ALT2-ASH/HW_RV1103_ESP32_Controller_Gateway/production/BOM_JLCPCB.csv

Comment | Designator | Footprint | JLCPCB Part #
CR2032 | BT1 | BatteryHolder_MYOUNG_BS-05_CR2032_Vertical_Overhang | C2902326
100nF / 100nF 50V | C1,C75,C201,C202,C203,C204,C205,C206,C207,C208,C209,C210 | C_0603_1608Metric | C14663
100nF | C2 | C_0805_2012Metric | C28233
33uF | C3 | CP_Elec_6.3x7.7 | C402500
2.2uF | C4,C5 | C_1210_3225Metric | C42400139
47uF | C6,C7,C8 | C_1206_3216Metric | C96123
47pF | C9 | C_0402_1005Metric | C1567
6.8nF | C10 | C_0402_1005Metric | C1542
22pF | C11 | C_0402_1005Metric | C1555
22uF | C12,C17,C18,C20,C71 | C_0603_1608Metric | C59461
10uF | C13,C21,C22,C24,C30,C31,C35,C36,C44,C55,C56 | C_0603_1608Metric | C19702
2.2uF | C14 | C_0603_1608Metric | C23630
100nF | C15,C23,C26,C27,C28,C29,C37,C38,C39,C40,C41,C42,C45,C46,C47,C48,C49,C50,C51,C53,C54,C60,C62,C63,C68,C70,C72,C73,C74,C76,C77,C78,C79 | C_0402_1005Metric | C1525
6.8pF | C16,C19 | C_0402_1005Metric | C1576
1uF | C25,C32,C33,C34,C52,C61,C67,C69 | C_0402_1005Metric | C52923
1nF | C43 | C_0402_1005Metric | C1523
18pF | C57,C58 | C_0402_1005Metric | C1549
4.7uF | C59 | C_0603_1608Metric | C19666
10nF | C64,C65 | C_0402_1005Metric | C15195
1nF 2kV | C66 | C_1206_3216Metric | C9196
SS510 | D1 | D_SMA | C65010
SMBJ33A | D2 | D_SMB | C78419
SS54 | D3 | D_SMA | C22452
SS56B | D4 | D_SMB | C18199180
SMF5.0A | D5,D6,D7,D18,D19,D20 | D_SOD-123F | C2759874
PSM712 | D8 | SOT-23 | C32677
SMF12A | D9 | D_SOD-123F | C19077506
1N4148W | D10,D11,D12,D13,D14,D15,D16,D17 | D_SOD-123 | C81598
LED | D201,D202,D203,D204,D205,D206,D207,D208 | LED_D3.0mm | C99771
BAT54C | D209 | SOT-23 | C37704
PTC 2.5A 48V | F1 | Fuse_2920_7451Metric | C49326264
BLM15PD121SN1D | FB1,FB2,FB3 | L_0402_1005Metric | C76891
DC 12-24V | J1 | DC-005-A200_XUNPU_Horizontal | C720557
USB_C_Receptacle_USB2.0_16P | J2 | USB_C_Receptacle_HRO_TYPE-C-31-D-06_Vertical | C22464422
FRONT_BTN / FRONT_LED | J4,J5 | PinHeader_1x02_P2.54mm_Vertical | C492401
HY911105AE | J6 | RJ45_Hanrun_HY911105AE_Horizontal | C69427
RS485 / I2C | J7,J10 | TerminalBlock_DB127V-5.0_1x04_P5.00mm | C430624
DIM 0-10V / IN1 | J9,J15 | TerminalBlock_DB127V-5.0_1x02_P5.00mm | C395885
PANEL CH1-4 / PANEL CH5-8 | J11,J12 | PinHeader_2x04_P2.54mm_Vertical | C492421
PANEL IN/PWR POST | J13 | PinHeader_1x06_P2.54mm_Vertical | C492405
IN2-3 | J14 | TerminalBlock_DB127V-5.0_1x03_P5.00mm | C395886
RELAY 1-4 / RELAY 5-8 | J16,J17 | TerminalBlock_bornier-8_P5.08mm | C5143711
G5Q-1A4 DC5 | K1,K2,K3,K4,K5,K6,K7,K8 | Relay_SPST_Omron-G5Q-1A | C5204063
8.2uH | L1 | L_Sunlord_SWPA8065S | C168161
2.2uH | L2,L3,L4 | L_Sunlord_SWPA4030S | C279948
RED | LED0,LED1 | LED_0603_1608Metric | C2286
AO3401A | Q1 | SOT-23 | C15127
AO3400A | Q2,Q3,Q4,Q5,Q6,Q7,Q8,Q9,Q10 | SOT-23 | C20917
470k | R1 | R_0402_1005Metric | C25790
150k | R2,R8 | R_0402_1005Metric | C25755
100k | R3,R16,R17,R18,R22,R23 | R_0402_1005Metric | C25741
18k | R4 | R_0402_1005Metric | C25762
75k | R5 | R_0402_1005Metric | C25798
12k | R6 | R_0402_1005Metric | C25752
10k | R7,R15,R21,R26,R41,R42,R46,R47,R48,R49,R50,R51,R52,R54,R60,R61,R66 | R_0402_1005Metric | C25744
200k | R9,R14 | R_0402_1005Metric | C25764
5.1k | R10,R11 | R_0402_1005Metric | C25905
33k | R12 | R_0402_1005Metric | C25779
51k | R13 | R_0402_1005Metric | C25794
4.7k | R19,R40,R83,R84,R87,R89,R90 | R_0402_1005Metric | C25900
100R | R20,R25,R33,R36,R63,R64,R65,R67,R68,R69,R70,R75,R76,R77,R78 | R_0402_1005Metric | C25076
330R | R24 | R_0402_1005Metric | C25104
1M | R27,R39 | R_0402_1005Metric | C26083
22R | R28,R43 | R_0402_1005Metric | C25092
1R | R29 | R_0402_1005Metric | C25086
240R | R30 | R_0402_1005Metric | C114755
6.04k | R31 | R_0402_1005Metric | C97819
0R | R32,R34,R35,R37 | R_0402_1005Metric | C17168
1k | R38,R85,R86,R88,R91 | R_0402_1005Metric | C11702
2.2k | R44,R45,R71,R72,R73,R74,R79,R80,R81,R82 | R_0402_1005Metric | C25879
390R | R53,R59 | R_0603_1608Metric | C23151
10R | R55,R58 | R_0805_2012Metric | C17415
33R | R56 | R_0402_1005Metric | C25105
120R | R57 | R_0603_1608Metric | C22787
22k | R62 | R_0402_1005Metric | C25768
0.47R | R92 | R_1206_3216Metric | C327076
2.2k | R201,R202,R203,R204,R205,R206,R207,R208 | R_0603_1608Metric | C4190
RECOVERY | SW1 | SW_SPST_TL3342 | C318884
SW_Push | SW201,SW202,SW203,SW204,SW205,SW206,SW207,SW208 | SW_PUSH_6mm_H8mm | C2845266
TPS54360BDDAR | U1 | TI_SO-PowerPAD-8_ThermalVias | C524806
TLV62569DBVR | U2,U4,U5 | SOT-23-5_TI_DBV0005A | C141836
USBLC6-2SC6 | U3,U10 | SOT-23-6 | C7519
RV1103G1 | U6 | QFN-88-1EP_9x9mm_P0.35mm_EP6.5x6.5mm | C5307358
W25N01KVZEIR | U7 | WSON-8-1EP_8x6mm_P1.27mm_EP3.4x4.3mm_HandSolder | C22472329
ESP32-C6-MINI-1U-H4 | U8 | ESP32-C6-MINI-1U | C20627095
SP3485EN-L/TR | U9 | SOIC-8_3.9x4.9mm_P1.27mm | C8963
LM321A | U11 | SOT-23-5 | C2842352
DAC5571 | U12 | SOT-23-6 | C24061
PCA9555PW | U201 | TSSOP-24_4.4x7.8mm_P0.65mm | C128392
RX8900CE | U202 | EPSON_CE-USON-10_USON-10_3.2x2.5mm_P0.7mm | C54946598
24MHz | Y1 | Crystal_SMD_2016-4Pin_2.0x1.6mm | C5261099
LED spacer 4x10mm | SP201,SP202,SP203,SP204,SP205,SP206,SP207,SP208 | LED_Spacer_4x10mm | C94096
