ALT2-ASH/HW_RV1103_ESP32_Controller_Gateway/rv1103_esp32.kicad_pcb

## KiCad design rv1103_esp32.kicad_pcb (2026-11-07)

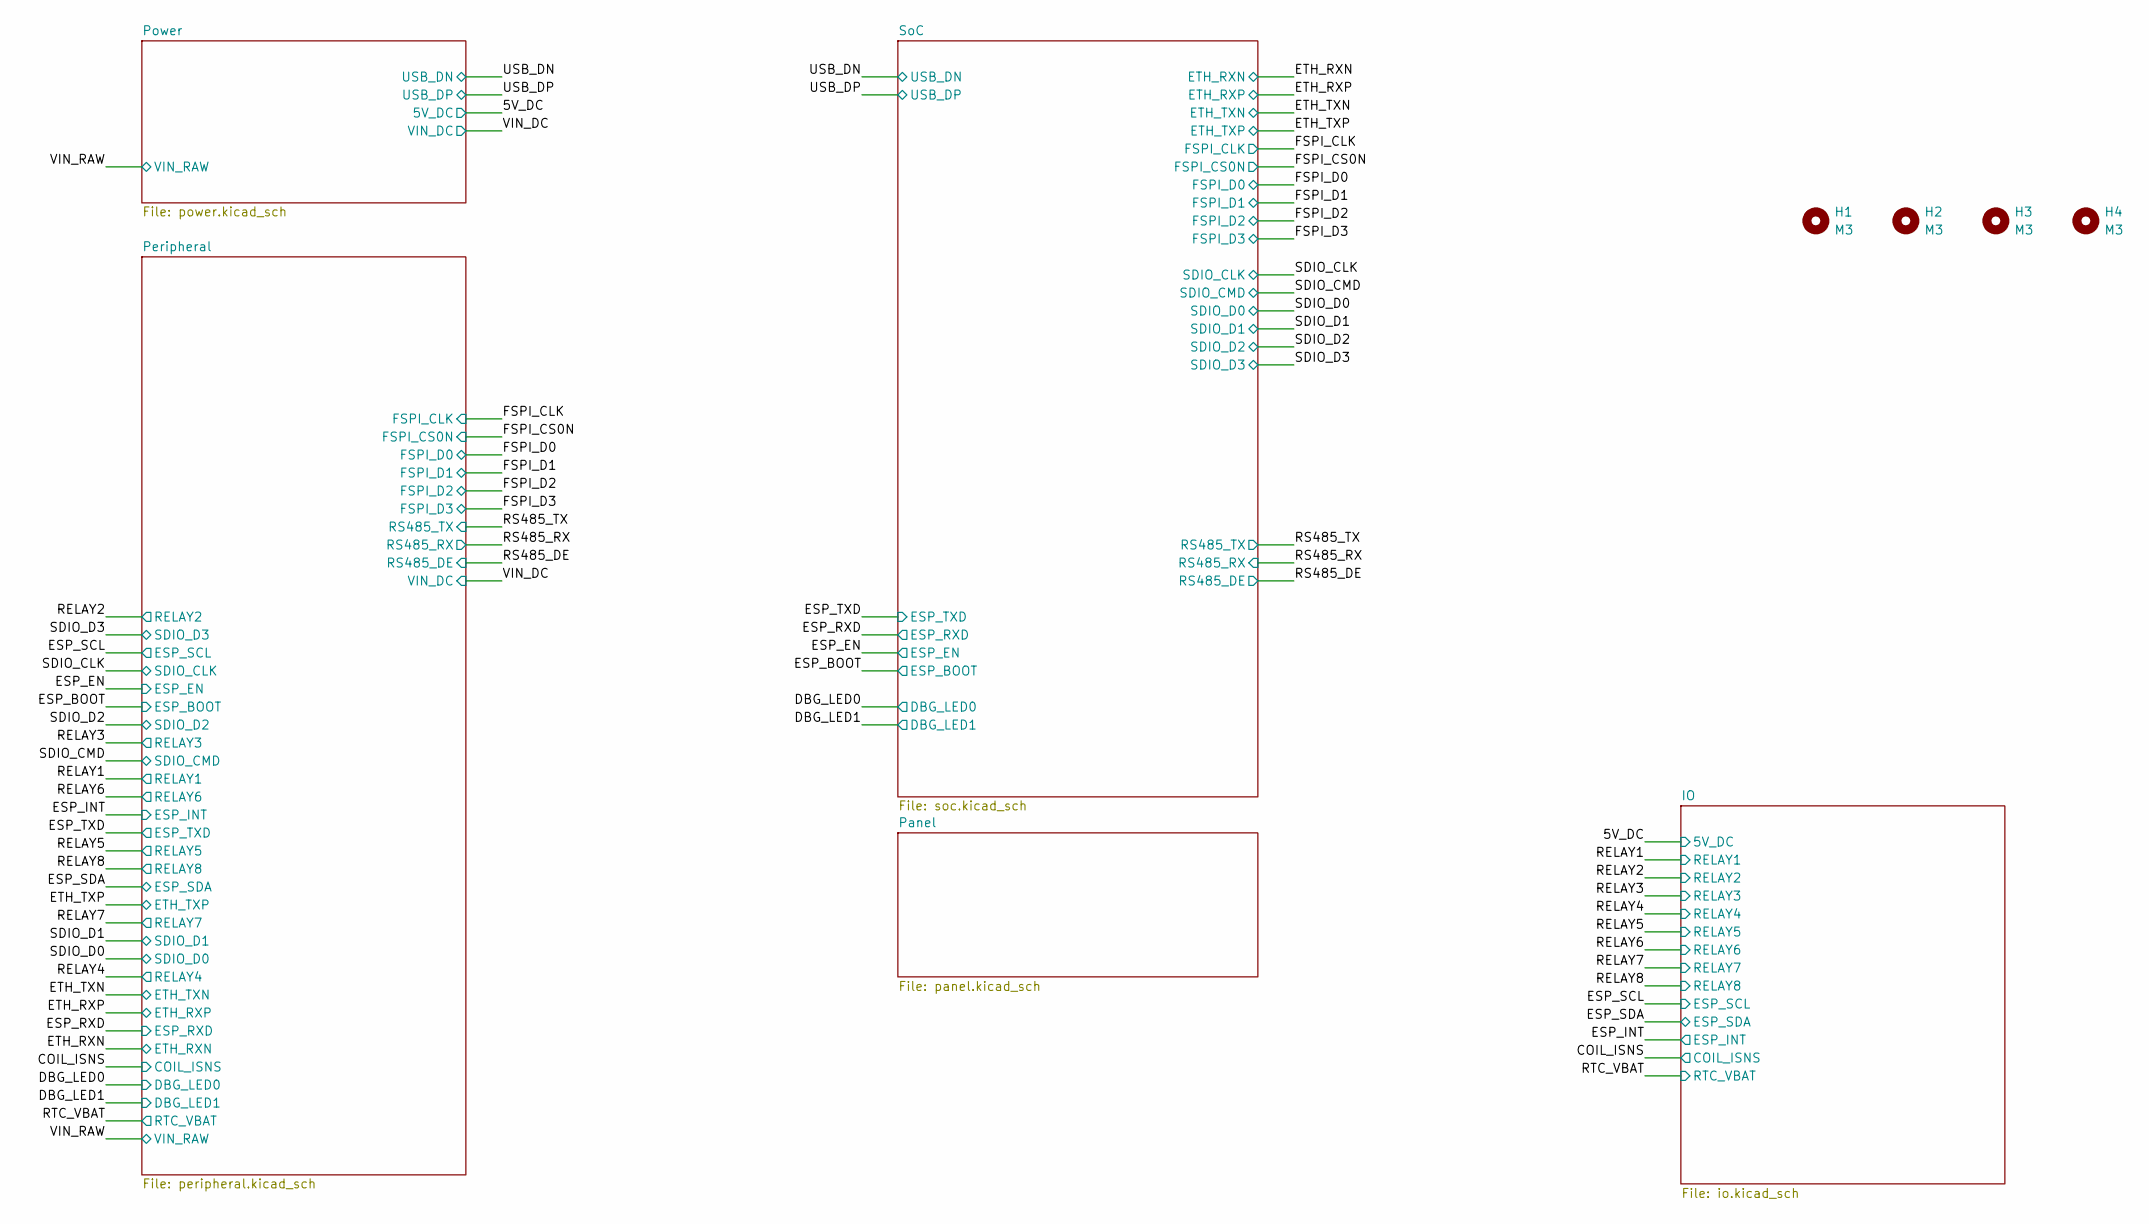
[picture p1: schematic rv1103_esp32.kicad_sch]

Parts:
H1, H2, H3, H4: M3; MountingHole_3.2mm_M3

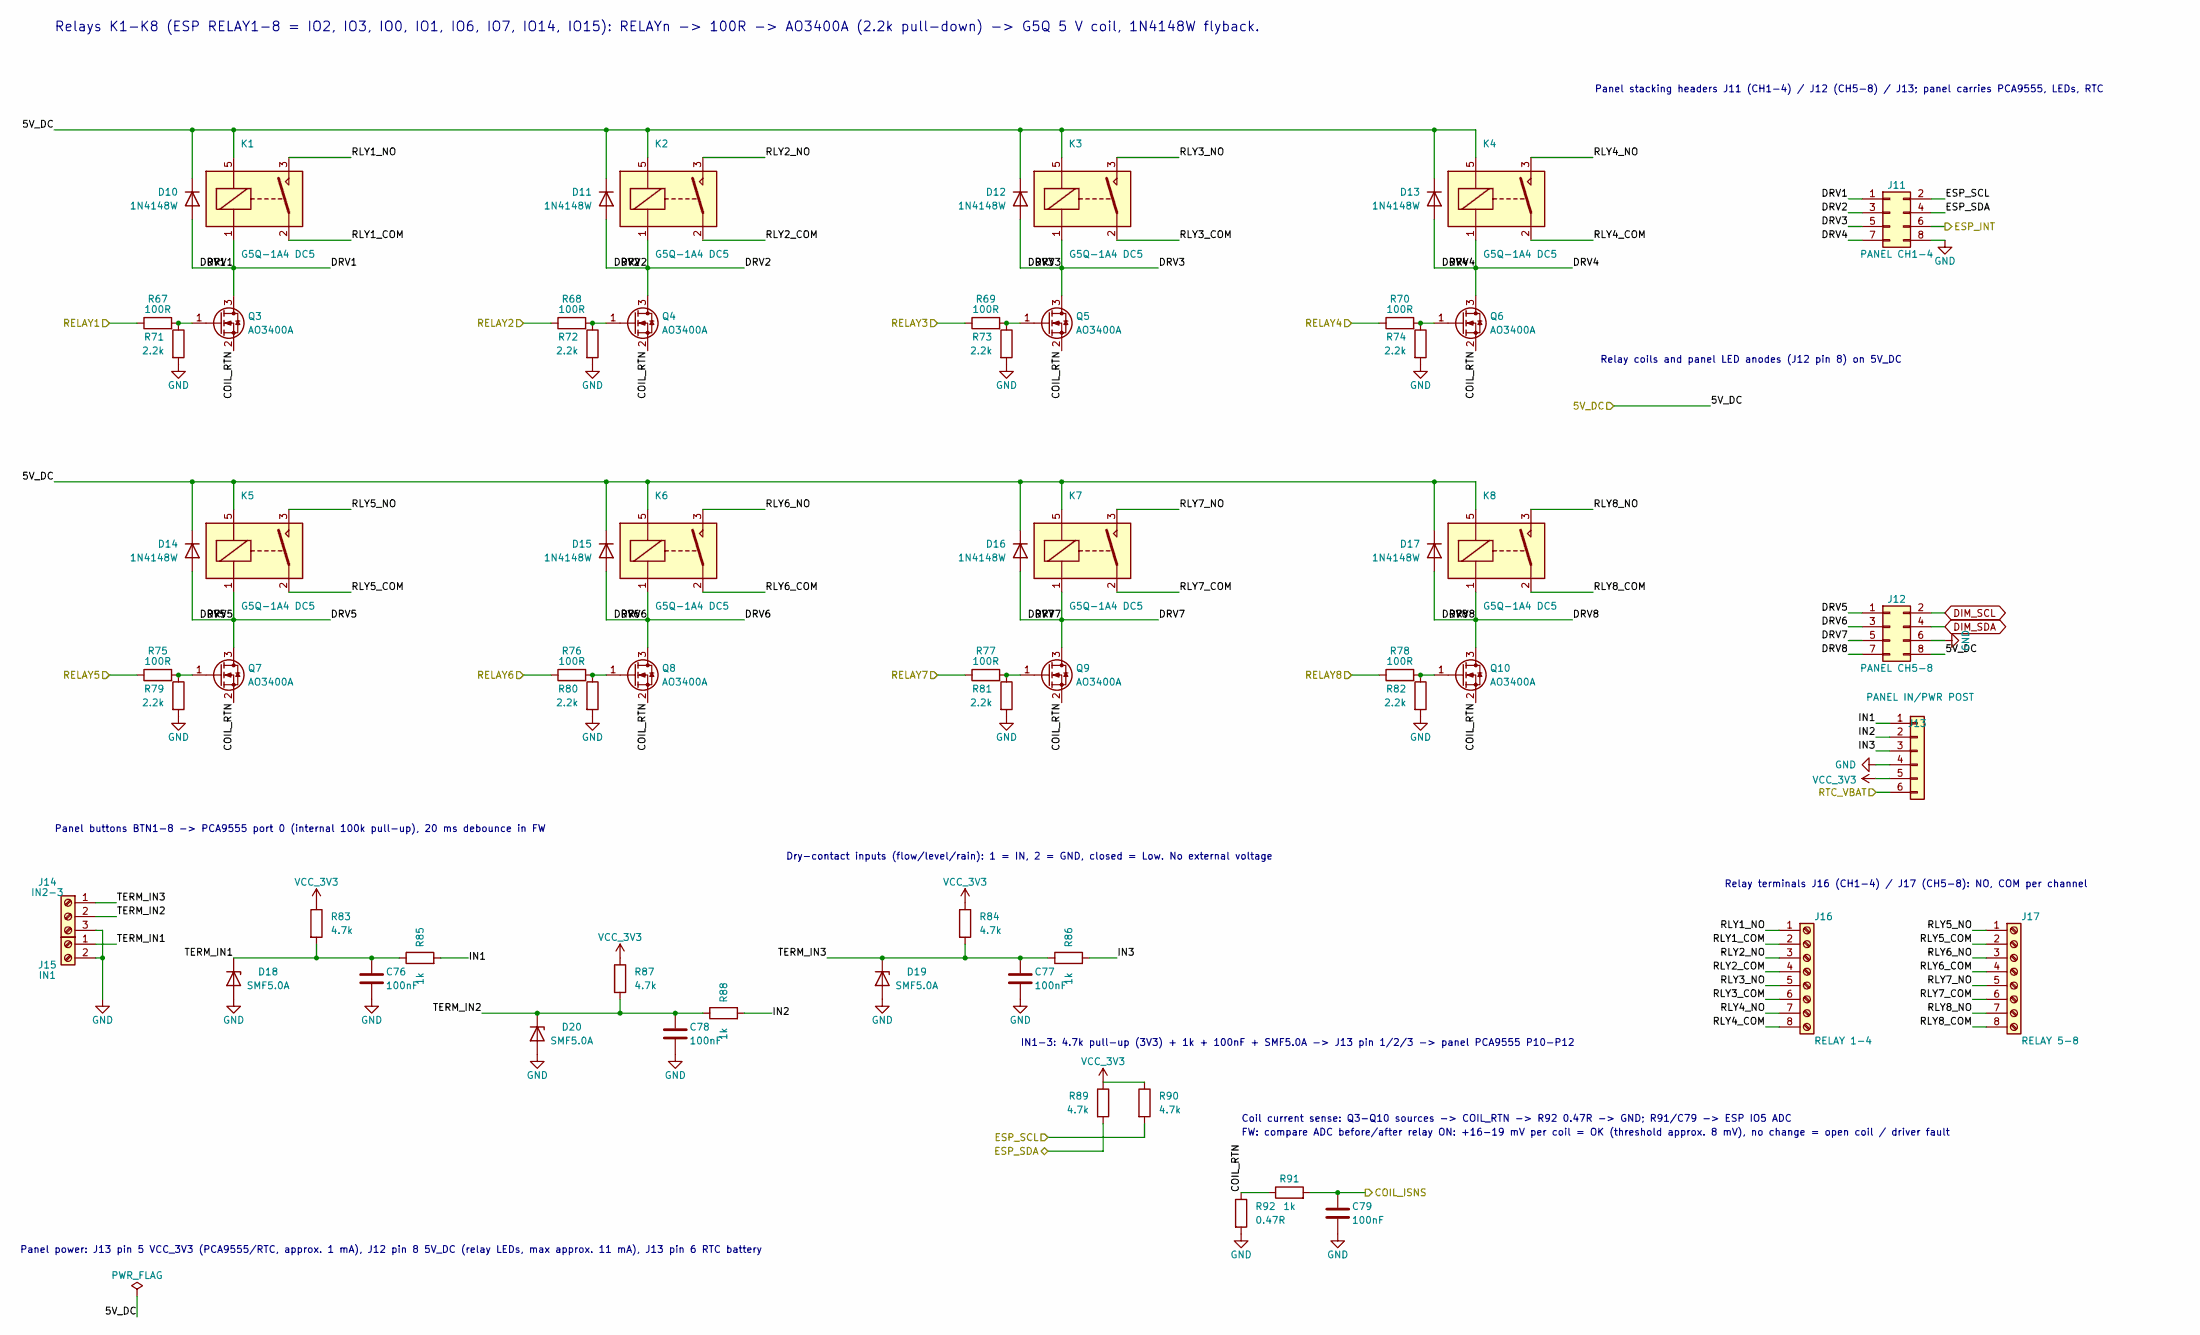
[picture p2: schematic io.kicad_sch]

Parts:
C76, C77, C78, C79: 100nF; C_0402_1005Metric; LCSC C1525
D10, D11, D12, D13, D14, D15, D16, D17: 1N4148W; D_SOD-123; MPN 1N4148W; LCSC C81598
D18, D19, D20: SMF5.0A; D_SOD-123F; LCSC C2759874
J11: PANEL CH1-4; PinHeader_2x04_P2.54mm_Vertical; MPN PZ254V-12-8P; LCSC C492421
J12: PANEL CH5-8; PinHeader_2x04_P2.54mm_Vertical; MPN PZ254V-12-8P; LCSC C492421
J13: PANEL IN/PWR POST; PinHeader_1x06_P2.54mm_Vertical; LCSC C492405
J14: IN2-3; TerminalBlock_DB127V-5.0_1x03_P5.00mm; MPN DB127V-5.0-3P-GN-S; LCSC C395886
J15: IN1; TerminalBlock_DB127V-5.0_1x02_P5.00mm; MPN DB127V-5.0-2P-GN-S; LCSC C395885
J16: RELAY 1-4; TerminalBlock_bornier-8_P5.08mm; MPN DB128V-5.08-8P-GN-S; LCSC C5143711
J17: RELAY 5-8; TerminalBlock_bornier-8_P5.08mm; MPN DB128V-5.08-8P-GN-S; LCSC C5143711
K1, K2, K3, K4, K5, K6, K7, K8: G5Q-1A4 DC5; Relay_SPST_Omron-G5Q-1A; MPN G5Q-1A4 DC5; LCSC_ALT C397241 G5Q-14 DC5 (SPDT 400mW coil, pa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
Q3, Q4, Q5, Q6, Q7, Q8, Q9, Q10: AO3400A; SOT-23; MPN AO3400A; LCSC C20917
R67, R68, R69, R70, R75, R76, R77, R78: 100R; R_0402_1005Metric; LCSC C25076
R71, R72, R73, R74, R79, R80, R81, R82: 2.2k; R_0402_1005Metric; LCSC C25879
R83, R84, R87, R89, R90: 4.7k; R_0402_1005Metric; LCSC C25900
R85, R86, R88, R91: 1k; R_0402_1005Metric; LCSC C11702
R92: 0.47R; R_1206_3216Metric; LCSC C327076

Connections:
/5V_DC: D10.1 (K), D11.1 (K), D12.1 (K), D13.1 (K), D14.1 (K), D15.1 (K), D16.1 (K), D17.1 (K), J12.8, K1.5, K2.5, K3.5, K4.5, K5.5, K6.5, K7.5, K8.5; also elsewhere on the board
/COIL_ISNS: C79.1, R91.2; also elsewhere on the board
/ESP_INT: J11.6; also elsewhere on the board
/ESP_SCL: J11.2, R90.2; also elsewhere on the board
/ESP_SDA: J11.4, R89.2; also elsewhere on the board
/IO/COIL_RTN: Q3.2 (S), Q4.2 (S), Q5.2 (S), Q6.2 (S), Q7.2 (S), Q8.2 (S), Q9.2 (S), Q10.2 (S), R91.1, R92.1
/IO/DRV1: D10.2 (A), J11.1, K1.1, Q3.3 (D)
/IO/DRV2: D11.2 (A), J11.3, K2.1, Q4.3 (D)
/IO/DRV3: D12.2 (A), J11.5, K3.1, Q5.3 (D)
/IO/DRV4: D13.2 (A), J11.7, K4.1, Q6.3 (D)
/IO/DRV5: D14.2 (A), J12.1, K5.1, Q7.3 (D)
/IO/DRV6: D15.2 (A), J12.3, K6.1, Q8.3 (D)
/IO/DRV7: D16.2 (A), J12.5, K7.1, Q9.3 (D)
/IO/DRV8: D17.2 (A), J12.7, K8.1, Q10.3 (D)
/IO/IN1: J13.1, R85.2
/IO/IN2: J13.2, R88.2
/IO/IN3: J13.3, R86.2
/IO/RLY1_COM: J16.2, K1.2
/IO/RLY1_NO: J16.1, K1.3
/IO/RLY2_COM: J16.4, K2.2
/IO/RLY2_NO: J16.3, K2.3
/IO/RLY3_COM: J16.6, K3.2
/IO/RLY3_NO: J16.5, K3.3
/IO/RLY4_COM: J16.8, K4.2
/IO/RLY4_NO: J16.7, K4.3
/IO/RLY5_COM: J17.2, K5.2
/IO/RLY5_NO: J17.1, K5.3
/IO/RLY6_COM: J17.4, K6.2
/IO/RLY6_NO: J17.3, K6.3
/IO/RLY7_COM: J17.6, K7.2
/IO/RLY7_NO: J17.5, K7.3
/IO/RLY8_COM: J17.8, K8.2
/IO/RLY8_NO: J17.7, K8.3
/IO/TERM_IN1: C76.1, D18.1 (K), J15.1, R83.2, R85.1
/IO/TERM_IN2: C78.1, D20.1 (K), J14.2, R87.2, R88.1
/IO/TERM_IN3: C77.1, D19.1 (K), J14.1, R84.2, R86.1
/RELAY1: R67.1; also elsewhere on the board
/RELAY2: R68.1; also elsewhere on the board
/RELAY3: R69.1; also elsewhere on the board
/RELAY4: R70.1; also elsewhere on the board
/RELAY5: R75.1; also elsewhere on the board
/RELAY6: R76.1; also elsewhere on the board
/RELAY7: R77.1; also elsewhere on the board
/RELAY8: R78.1; also elsewhere on the board
/RTC_VBAT: J13.6; also elsewhere on the board
DIM_SCL: J12.2; also elsewhere on the board
DIM_SDA: J12.4; also elsewhere on the board
GND: C76.2, C77.2, C78.2, C79.2, D18.2 (A), D19.2 (A), D20.2 (A), J11.8, J12.6, J13.4, J14.3, J15.2, R71.2, R72.2, R73.2, R74.2, R79.2, R80.2, R81.2, R82.2, R92.2; also elsewhere on the board
unnamed: Q3.1 (G), R67.2, R71.1
unnamed: Q4.1 (G), R68.2, R72.1
unnamed: Q5.1 (G), R69.2, R73.1
unnamed: Q6.1 (G), R70.2, R74.1
unnamed: Q7.1 (G), R75.2, R79.1
unnamed: Q8.1 (G), R76.2, R80.1
unnamed: Q9.1 (G), R77.2, R81.1
unnamed: Q10.1 (G), R78.2, R82.1
VCC_3V3: J13.5, R83.1, R84.1, R87.1, R89.1, R90.1; also elsewhere on the board

Notes on the sheet:
FW: compare ADC before/after relay ON: +16-19 mV per coil = OK (threshold approx. 8 mV), no change = open coil / driver fault
Relay coils and panel LED anodes (J12 pin 8) on 5V_DC
Panel stacking headers J11 (CH1-4) / J12 (CH5-8) / J13; panel carries PCA9555, LEDs, RTC
IN1-3: 4.7k pull-up (3V3) + 1k + 100nF + SMF5.0A -> J13 pin 1/2/3 -> panel PCA9555 P10-P12
Relay terminals J16 (CH1-4) / J17 (CH5-8): NO, COM per channel
Panel power: J13 pin 5 VCC_3V3 (PCA9555/RTC, approx. 1 mA), J12 pin 8 5V_DC (relay LEDs, max approx. 11 mA), J13 pin 6 RTC battery
Coil current sense: Q3-Q10 sources -> COIL_RTN -> R92 0.47R -> GND; R91/C79 -> ESP IO5 ADC
Relays K1-K8 (ESP RELAY1-8 = IO2, IO3, IO0, IO1, IO6, IO7, IO14, IO15): RELAYn -> 100R -> AO3400A (2.2k pull-down) -> G5Q 5 V coil, 1N4148W flyback.
Panel buttons BTN1-8 -> PCA9555 port 0 (internal 100k pull-up), 20 ms debounce in FW
Dry-contact inputs (flow/level/rain): 1 = IN, 2 = GND, closed = Low. No external voltage

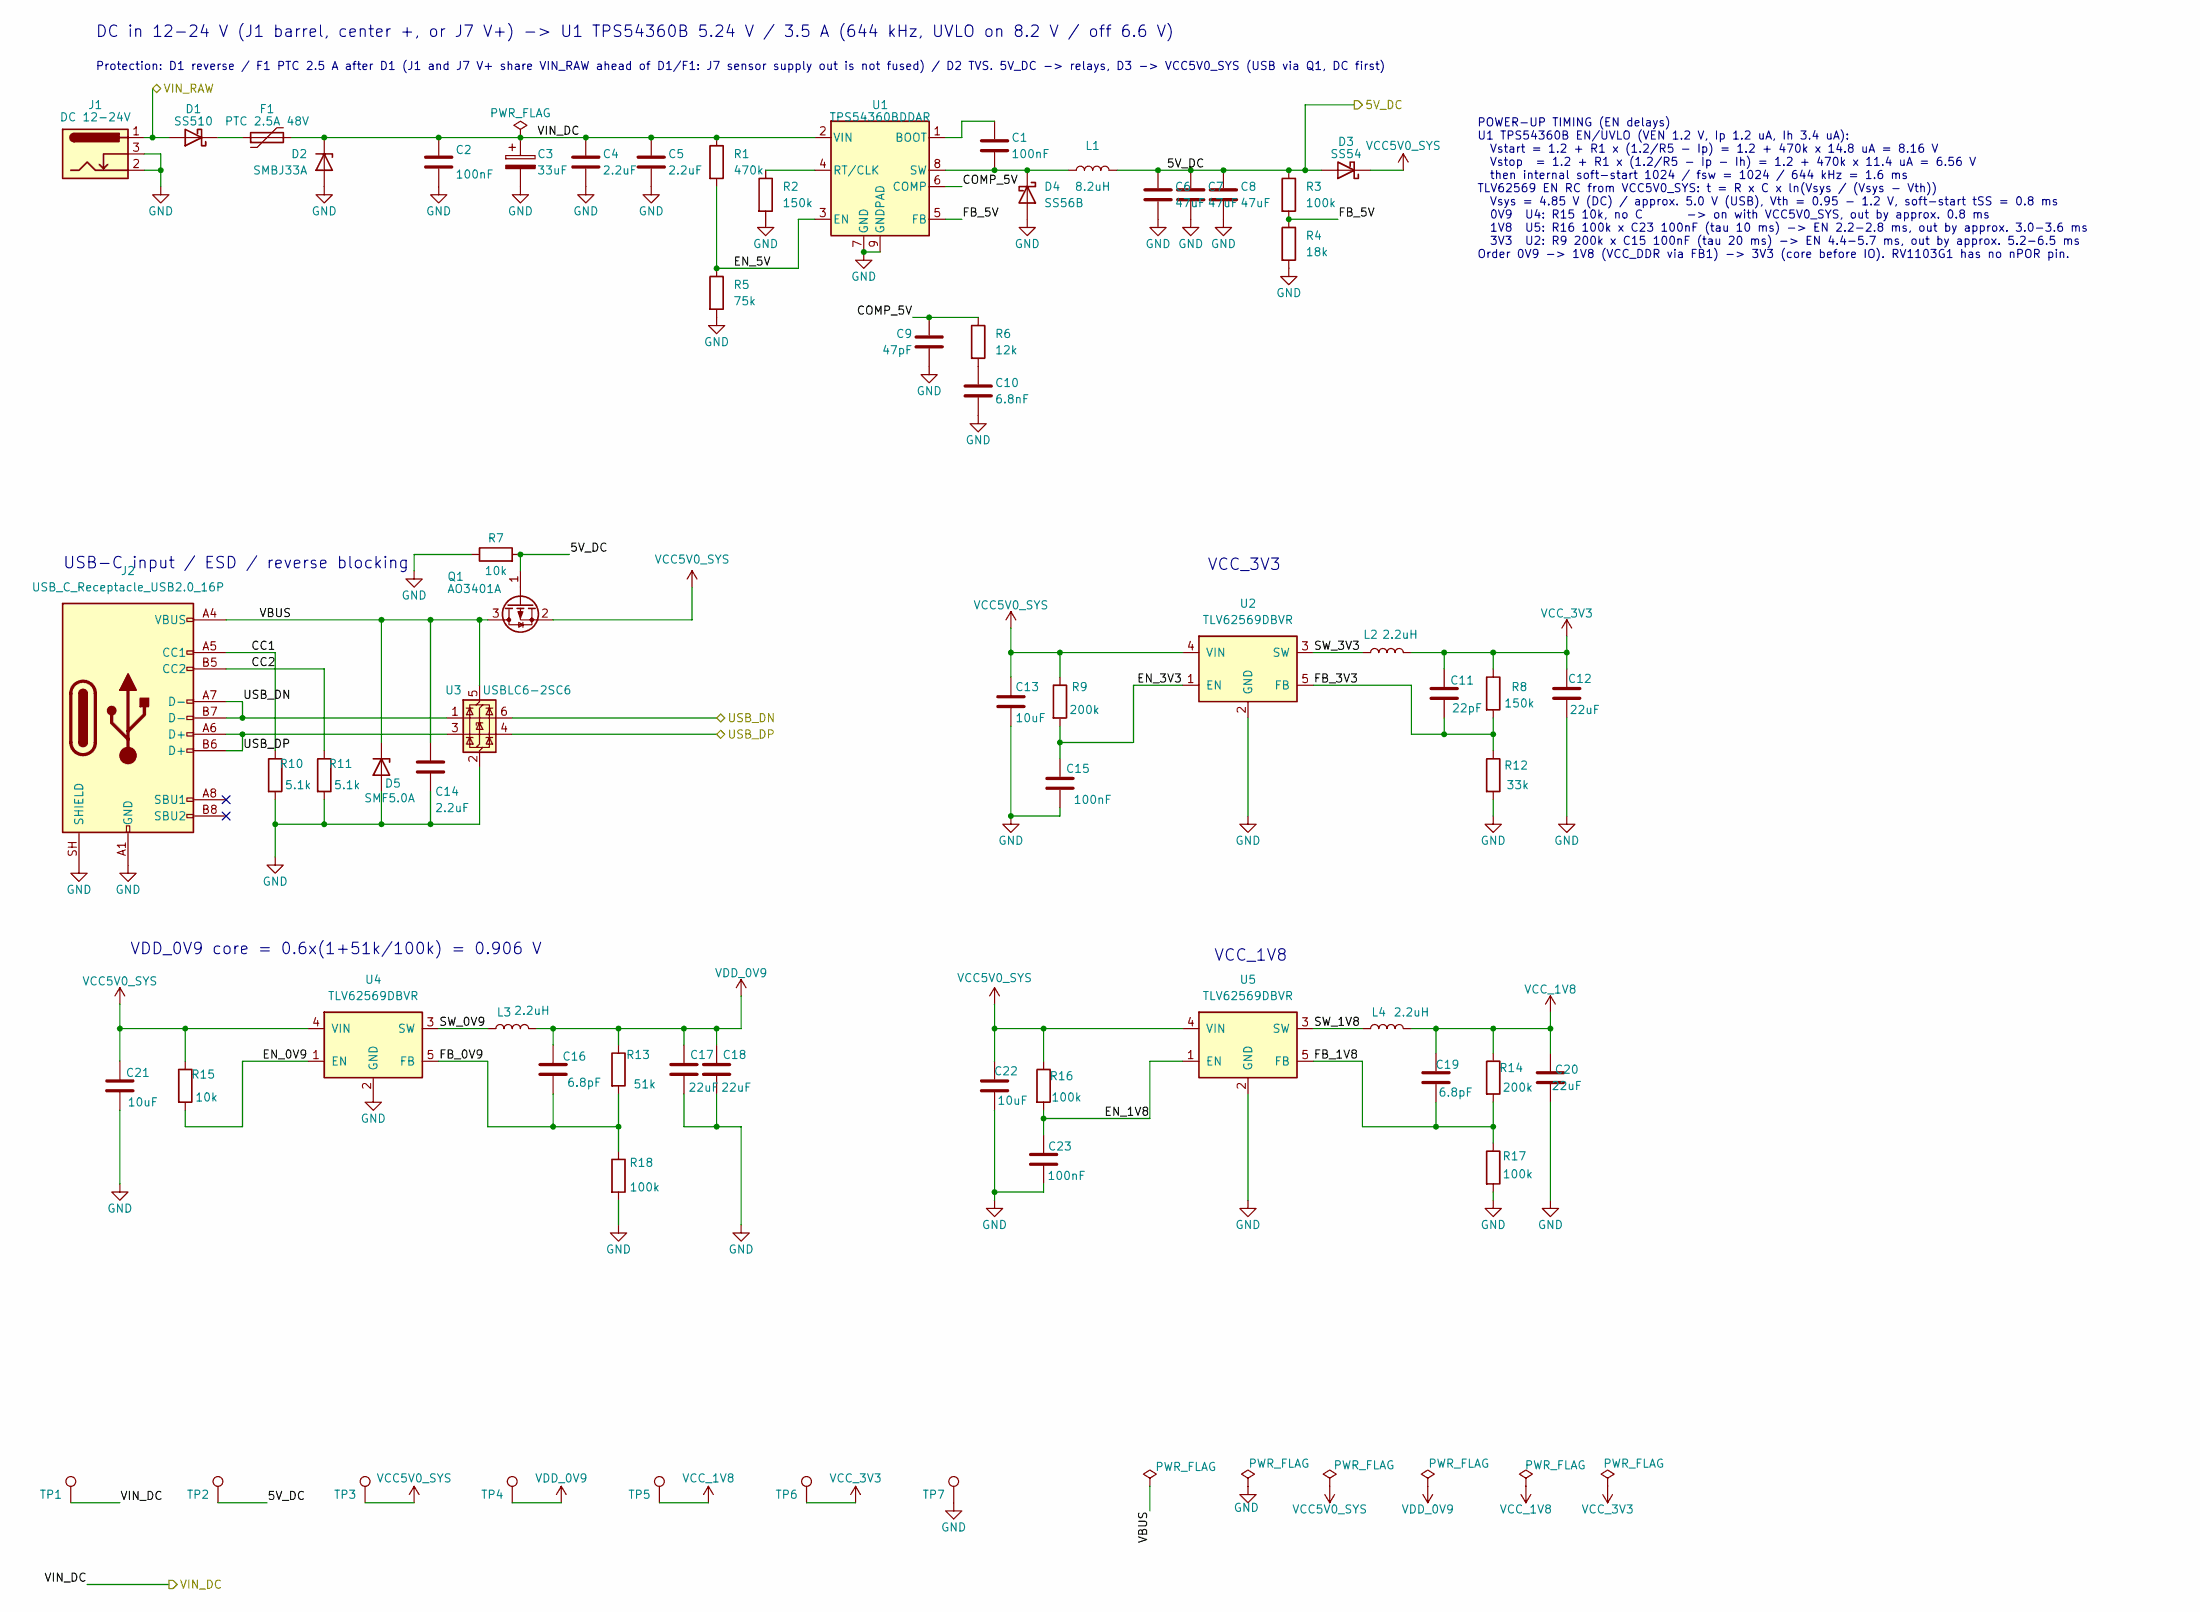
[picture p3: schematic power.kicad_sch]

Parts:
C1: 100nF; C_0603_1608Metric; LCSC C14663
C2: 100nF; C_0805_2012Metric; LCSC C28233
C3: 33uF; CP_Elec_6.3x7.7; Voltage 63V; MPN MV330M063E077ETR; LCSC C402500
C4, C5: 2.2uF; C_1210_3225Metric; Voltage 100V; MPN 1210B225K101NT; LCSC C42400139
C6, C7, C8: 47uF; C_1206_3216Metric; Voltage 10V; MPN CL31A476MPHNNNE; LCSC C96123
C9: 47pF; C_0402_1005Metric; MPN 0402CG470J500NT; LCSC C1567
C10: 6.8nF; C_0402_1005Metric; LCSC C1542
C11: 22pF; C_0402_1005Metric; MPN 0402CG220J500NT; LCSC C1555
C12, C17, C18, C20: 22uF; C_0603_1608Metric; LCSC C59461
C13, C21, C22: 10uF; C_0603_1608Metric; LCSC C19702
C14: 2.2uF; C_0603_1608Metric; LCSC C23630
C15, C23: 100nF; C_0402_1005Metric; LCSC C1525
C16, C19: 6.8pF; C_0402_1005Metric; LCSC C1576
D1: SS510; D_SMA; MPN SS510; LCSC C65010
D2: SMBJ33A; D_SMB; MPN SMBJ33A; LCSC C78419
D3: SS54; D_SMA; MPN SS54; LCSC C22452
D4: SS56B; D_SMB; MPN SS56B; LCSC C18199180
D5: SMF5.0A; D_SOD-123F; LCSC C2759874
F1: PTC 2.5A 48V; Fuse_2920_7451Metric; MPN 2920L250/48GR; LCSC C49326264
J1: DC 12-24V; DC-005-A200_XUNPU_Horizontal; MPN DC-005-A200; LCSC C720557
J2: USB_C_Receptacle_USB2.0_16P; USB_C_Receptacle_HRO_TYPE-C-31-D-06_Vertical; MPN TYPE-C-31-D-06A; LCSC C22464422
L1: 8.2uH; L_Sunlord_SWPA8065S; MPN FNR8065S8R2MT; LCSC C168161
L2, L3, L4: 2.2uH; L_Sunlord_SWPA4030S; MPN SWPA4030S2R2NT; LCSC C279948
Q1: AO3401A; SOT-23; MPN AO3401A; LCSC C15127
R1: 470k; R_0402_1005Metric; Tolerance 1%; MPN 0402WGF4703TCE; LCSC C25790
R2, R8: 150k; R_0402_1005Metric; Tolerance 1%; MPN 0402WGF1503TCE; LCSC C25755
R3: 100k; R_0402_1005Metric; Tolerance 1%; MPN 0402WGF1003TCE; LCSC C25741
R4: 18k; R_0402_1005Metric; Tolerance 1%; MPN 0402WGF1802TCE; LCSC C25762
R5: 75k; R_0402_1005Metric; Tolerance 1%; MPN 0402WGF7502TCE; LCSC C25798
R6: 12k; R_0402_1005Metric; Tolerance 1%; MPN 0402WGF1202TCE; LCSC C25752
R7, R15: 10k; R_0402_1005Metric; LCSC C25744
R9: 200k; R_0402_1005Metric; LCSC C25764
R10, R11: 5.1k; R_0402_1005Metric; LCSC C25905
R12: 33k; R_0402_1005Metric; Tolerance 1%; MPN 0402WGF3302TCE; LCSC C25779
R13: 51k; R_0402_1005Metric; Tolerance 1%; MPN 0402WGF5102TCE; LCSC C25794
R14: 200k; R_0402_1005Metric; Tolerance 1%; LCSC C25764
R16: 100k; R_0402_1005Metric; LCSC C25741
R17, R18: 100k; R_0402_1005Metric; Tolerance 1%; LCSC C25741
TP1: VIN_DC; TestPoint_Pad_D1.5mm
TP2: 5V_DC; TestPoint_Pad_D1.5mm
TP3: VCC5V0_SYS; TestPoint_Pad_D1.5mm
TP4: VDD_0V9; TestPoint_Pad_D1.5mm
TP5: VCC_1V8; TestPoint_Pad_D1.5mm
TP6: VCC_3V3; TestPoint_Pad_D1.5mm
TP7: GND; TestPoint_Pad_D1.5mm
U1: TPS54360BDDAR; TI_SO-PowerPAD-8_ThermalVias; MPN TPS54360BDDAR; LCSC C524806
U2, U4, U5: TLV62569DBVR; SOT-23-5_TI_DBV0005A; MPN TLV62569DBVR; LCSC C141836
U3: USBLC6-2SC6; SOT-23-6; LCSC C7519

Connections:
/5V_DC: C6.1, C7.1, C8.1, D3.2 (A), L1.2, Q1.1 (G), R3.1, R7.2, TP2.1 (1_1); also elsewhere on the board
/Power/CC1: J2.A5 (CC1), R10.1
/Power/CC2: J2.B5 (CC2), R11.1
/Power/COMP_5V: C9.1, R6.1, U1.6 (COMP)
/Power/EN_0V9: R15.2, U4.1 (EN)
/Power/EN_1V8: C23.1, R16.2, U5.1 (EN)
/Power/EN_3V3: C15.1, R9.2, U2.1 (EN)
/Power/EN_5V: R1.2, R5.1, U1.3 (EN)
/Power/FB_0V9: C16.2, R13.2, R18.1, U4.5 (FB)
/Power/FB_1V8: C19.2, R14.2, R17.1, U5.5 (FB)
/Power/FB_3V3: C11.2, R8.2, R12.1, U2.5 (FB)
/Power/FB_5V: R3.2, R4.1, U1.5 (FB)
/Power/SW_0V9: L3.1, U4.3 (SW)
/Power/SW_1V8: L4.1, U5.3 (SW)
/Power/SW_3V3: L2.1, U2.3 (SW)
/Power/VBUS: C14.1, D5.1 (K), J2.A4 (VBUS), J2.A9 (VBUS), J2.B4 (VBUS), J2.B9 (VBUS), Q1.3 (D), U3.5 (VBUS)
/USB_DN: J2.A7 (D-), J2.B7 (D-), U3.1 (I/O1), U3.6 (I/O1); also elsewhere on the board
/USB_DP: J2.A6 (D+), J2.B6 (D+), U3.3 (I/O2), U3.4 (I/O2); also elsewhere on the board
/VIN_DC: C2.1, C3.1, C4.1, C5.1, D2.1 (K), F1.2, R1.1, TP1.1 (1_1), U1.2 (VIN); also elsewhere on the board
/VIN_RAW: D1.2 (A), J1.1; also elsewhere on the board
GND: C2.2, C3.2, C4.2, C5.2, C6.2, C7.2, C8.2, C9.2, C10.2, C12.2, C13.2, C14.2, C15.2, C17.2, C18.2, C20.2, C21.2, C22.2, C23.2, D2.2 (A), D4.2 (A), D5.2 (A), J1.2, J1.3, J2.A1 (GND), J2.A12 (GND), J2.B1 (GND), J2.B12 (GND), J2.SH (SHIELD), R2.2, R4.2, R5.2, R7.1, R10.2, R11.2, R12.2, R17.2, R18.2, TP7.1 (1_1), U1.7 (GND), U1.9 (GNDPAD), U2.2 (GND), U3.2 (GND), U4.2 (GND), U5.2 (GND); also elsewhere on the board
unnamed: C10.1, R6.2
unnamed: D1.1 (K), F1.1
unnamed: C1.2, D4.1 (K), L1.1, U1.8 (SW)
unnamed: C1.1, U1.1 (BOOT)
unnamed: R2.1, U1.4 (RT/CLK)
VCC5V0_SYS: C13.1, C21.1, C22.1, D3.1 (K), Q1.2 (S), R9.1, R15.1, R16.1, TP3.1 (1_1), U2.4 (VIN), U4.4 (VIN), U5.4 (VIN)
VCC_1V8: C19.1, C20.1, L4.2, R14.1, TP5.1 (1_1); also elsewhere on the board
VCC_3V3: C11.1, C12.1, L2.2, R8.1, TP6.1 (1_1); also elsewhere on the board
VDD_0V9: C16.1, C17.1, C18.1, L3.2, R13.1, TP4.1 (1_1); also elsewhere on the board

Notes on the sheet:
VCC_3V3
DC in 12-24 V (J1 barrel, center +, or J7 V+) -> U1 TPS54360B 5.24 V / 3.5 A (644 kHz, UVLO on 8.2 V / off 6.6 V)
POWER-UP TIMING (EN delays) U1 TPS54360B EN/UVLO (VEN 1.2 V, Ip 1.2 uA, Ih 3.4 uA): Vstart = 1.2 + R1 x (1.2/R5 - Ip) = 1.2 + 470k x 14.8 uA = 8.16 V Vstop = 1.2 + R1 x (1.2/R5 - Ip - Ih) = 1.2 + 470k x 11.4 uA = 6.56 V then internal soft-start 1024 / fsw = 1024 / 644 kHz = 1.6 ms TLV62569 EN RC fr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
VDD_0V9 core = 0.6x(1+51k/100k) = 0.906 V
Protection: D1 reverse / F1 PTC 2.5 A after D1 (J1 and J7 V+ share VIN_RAW ahead of D1/F1: J7 sensor supply out is not fused) / D2 TVS. 5V_DC -> relays, D3 -> VCC5V0_SYS (USB via Q1, DC first)
VCC_1V8
USB-C input / ESD / reverse blocking

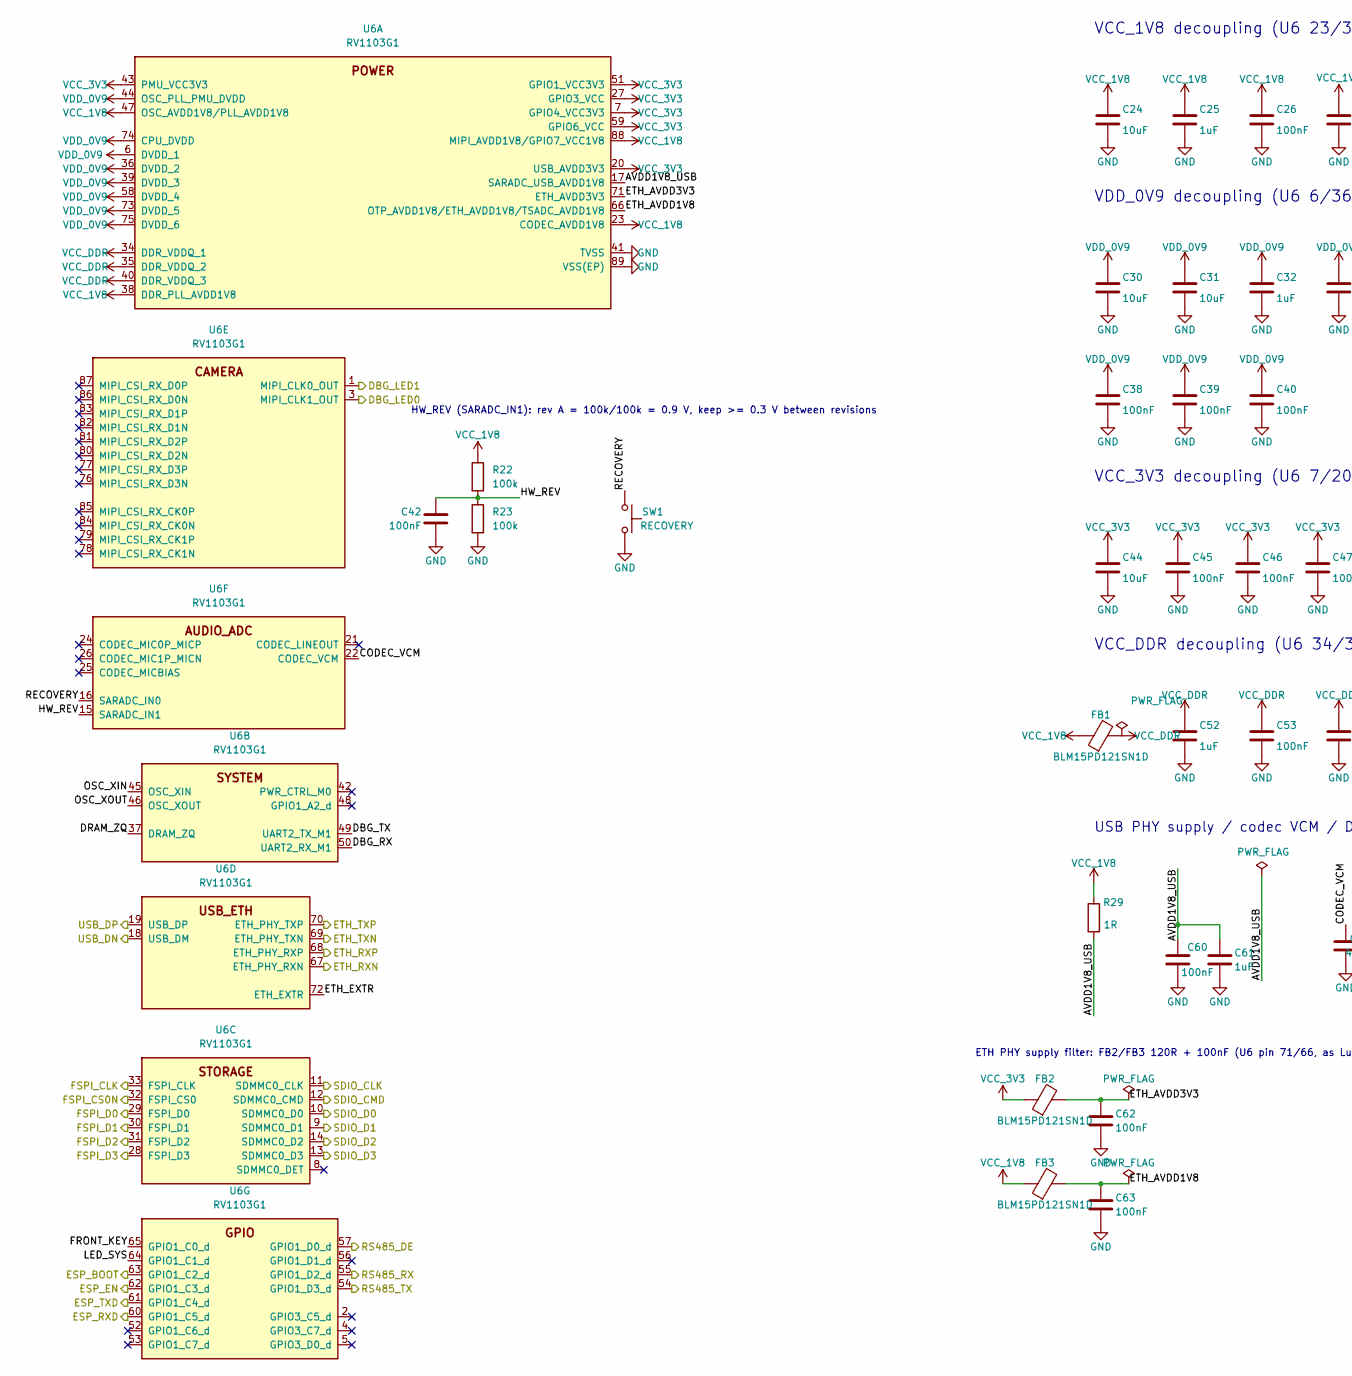
[picture p4: schematic soc.kicad_sch, part in row 1, column 1]

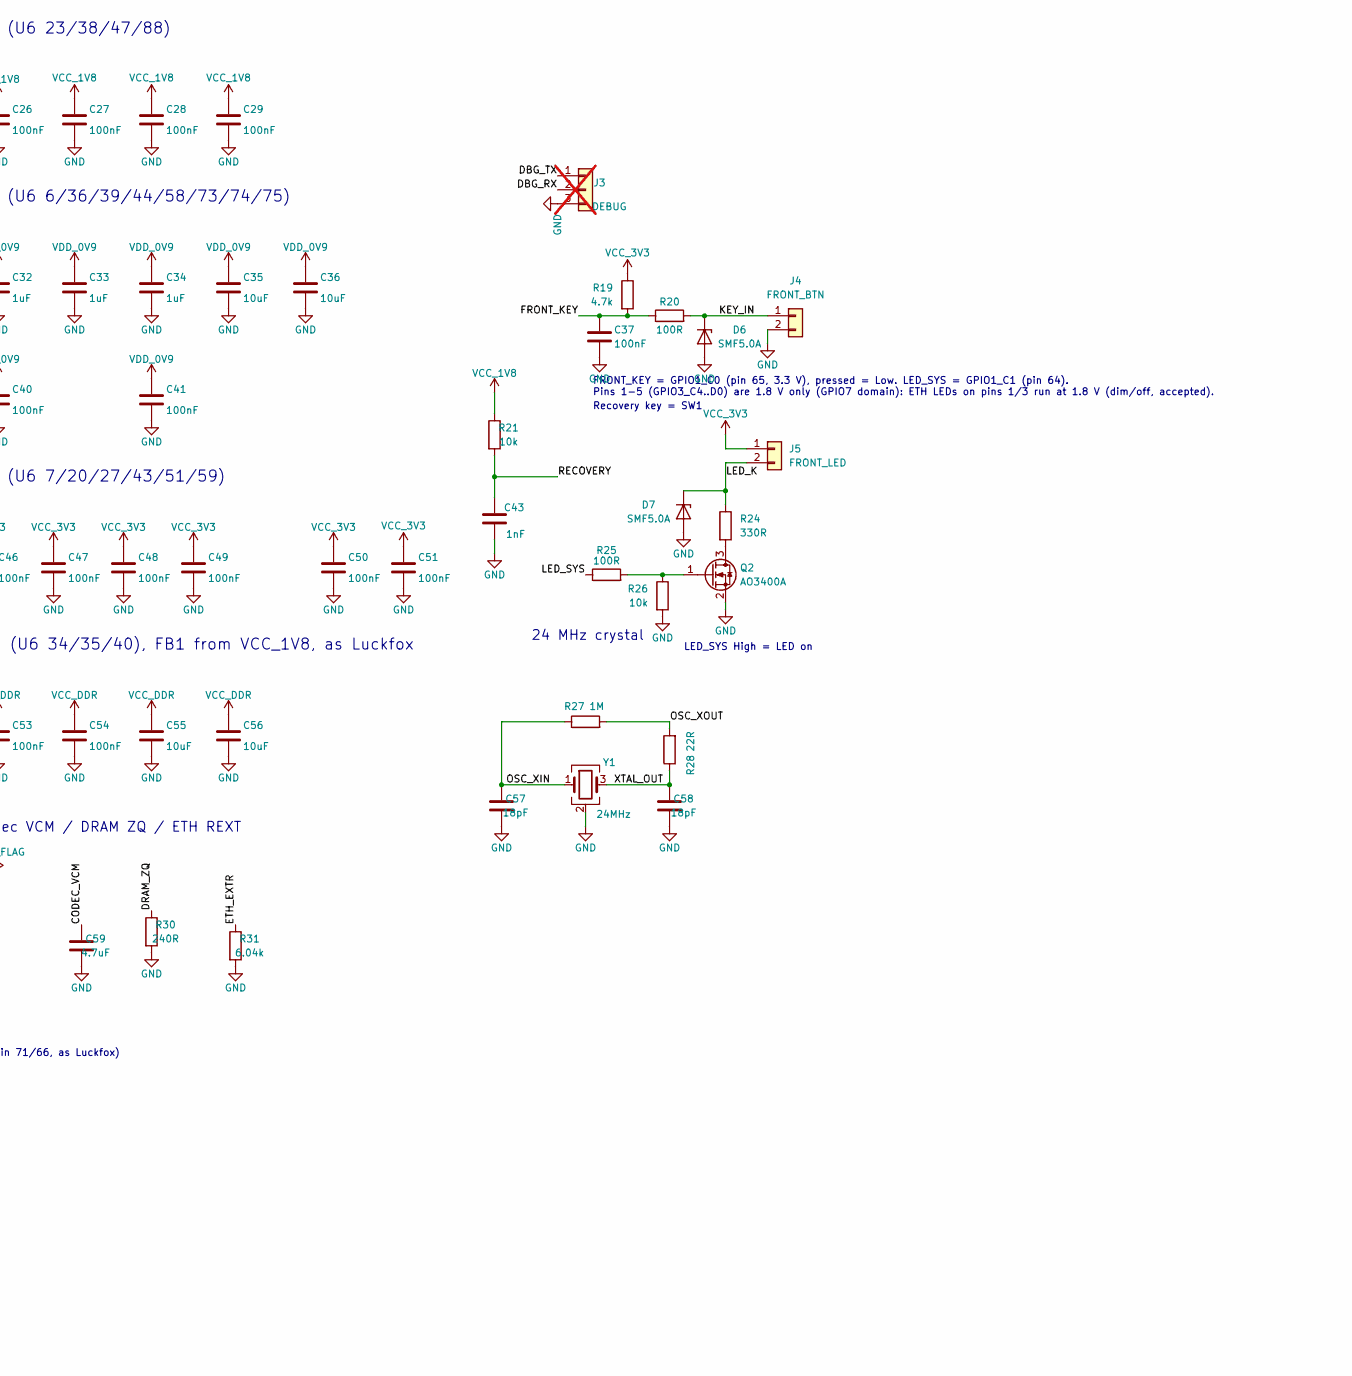
[picture p5: schematic soc.kicad_sch, part in row 1, column 2]

Parts:
C24, C30, C31, C35, C36, C44, C55, C56: 10uF; C_0603_1608Metric; LCSC C19702
C25, C32, C33, C34, C52, C61: 1uF; C_0402_1005Metric; LCSC C52923
C26, C27, C28, C29, C37, C38, C39, C40, C41, C42, C45, C46, C47, C48, C49, C50, C51, C53, C54, C60, C62, C63: 100nF; C_0402_1005Metric; LCSC C1525
C43: 1nF; C_0402_1005Metric; LCSC C1523
C57, C58: 18pF; C_0402_1005Metric; LCSC C1549
C59: 4.7uF; C_0603_1608Metric; LCSC C19666
D6, D7: SMF5.0A; D_SOD-123F; LCSC C2759874
FB1, FB2, FB3: BLM15PD121SN1D; L_0402_1005Metric; LCSC C76891
J3: DEBUG; PinHeader_1x03_P2.54mm_Vertical; not fitted
J4: FRONT_BTN; PinHeader_1x02_P2.54mm_Vertical; MPN PZ254V-11-02P; LCSC C492401
J5: FRONT_LED; PinHeader_1x02_P2.54mm_Vertical; MPN PZ254V-11-02P; LCSC C492401
Q2: AO3400A; SOT-23; MPN AO3400A; LCSC C20917
R19: 4.7k; R_0402_1005Metric; LCSC C25900
R20, R25: 100R; R_0402_1005Metric; LCSC C25076
R21, R26: 10k; R_0402_1005Metric; LCSC C25744
R22, R23: 100k; R_0402_1005Metric; LCSC C25741
R24: 330R; R_0402_1005Metric; LCSC C25104
R27: 1M; R_0402_1005Metric; LCSC C26083
R28: 22R; R_0402_1005Metric; LCSC C25092
R29: 1R; R_0402_1005Metric; MPN RC0402FR-071RL; LCSC C25086
R30: 240R; R_0402_1005Metric; Tolerance 1%; MPN RC0402FR-07240RL; LCSC C114755
R31: 6.04k; R_0402_1005Metric; Tolerance 1%; MPN RC0402FR-076K04L; LCSC C97819
SW1: RECOVERY; SW_SPST_TL3342; MPN TS-1187A-B-A-B; LCSC C318884
U6: RV1103G1; QFN-88-1EP_9x9mm_P0.35mm_EP6.5x6.5mm; MPN RV1103G1; LCSC C5307358
Y1: 24MHz; Crystal_SMD_2016-4Pin_2.0x1.6mm; LCSC C5261099

Connections:
/DBG_LED0: U6.3 (MIPI_CLK1_OUT); also elsewhere on the board
/DBG_LED1: U6.1 (MIPI_CLK0_OUT); also elsewhere on the board
/ESP_BOOT: U6.63 (GPIO1_C2_d); also elsewhere on the board
/ESP_EN: U6.62 (GPIO1_C3_d); also elsewhere on the board
/ESP_RXD: U6.60 (GPIO1_C5_d); also elsewhere on the board
/ESP_TXD: U6.61 (GPIO1_C4_d); also elsewhere on the board
/ETH_RXN: U6.67 (ETH_PHY_RXN); also elsewhere on the board
/ETH_RXP: U6.68 (ETH_PHY_RXP); also elsewhere on the board
/ETH_TXN: U6.69 (ETH_PHY_TXN); also elsewhere on the board
/ETH_TXP: U6.70 (ETH_PHY_TXP); also elsewhere on the board
/FSPI_CLK: U6.33 (FSPI_CLK); also elsewhere on the board
/FSPI_CS0N: U6.32 (FSPI_CS0); also elsewhere on the board
/FSPI_D0: U6.29 (FSPI_D0); also elsewhere on the board
/FSPI_D1: U6.30 (FSPI_D1); also elsewhere on the board
/FSPI_D2: U6.31 (FSPI_D2); also elsewhere on the board
/FSPI_D3: U6.28 (FSPI_D3); also elsewhere on the board
/RS485_DE: U6.57 (GPIO1_D0_d); also elsewhere on the board
/RS485_RX: U6.55 (GPIO1_D2_d); also elsewhere on the board
/RS485_TX: U6.54 (GPIO1_D3_d); also elsewhere on the board
/SDIO_CLK: U6.11 (SDMMC0_CLK); also elsewhere on the board
/SDIO_CMD: U6.12 (SDMMC0_CMD); also elsewhere on the board
/SDIO_D0: U6.10 (SDMMC0_D0); also elsewhere on the board
/SDIO_D1: U6.9 (SDMMC0_D1); also elsewhere on the board
/SDIO_D2: U6.14 (SDMMC0_D2); also elsewhere on the board
/SDIO_D3: U6.13 (SDMMC0_D3); also elsewhere on the board
/SoC/AVDD1V8_USB: C60.1, C61.1, R29.2, U6.17 (SARADC_USB_AVDD1V8)
/SoC/CODEC_VCM: C59.1, U6.22 (CODEC_VCM)
/SoC/DBG_RX: J3.2, U6.50 (UART2_RX_M1)
/SoC/DBG_TX: J3.1, U6.49 (UART2_TX_M1)
/SoC/DRAM_ZQ: R30.1, U6.37 (DRAM_ZQ)
/SoC/ETH_AVDD1V8: C63.1, FB3.2, U6.66 (OTP_AVDD1V8/ETH_AVDD1V8/TSADC_AVDD1V8)
/SoC/ETH_AVDD3V3: C62.1, FB2.2, U6.71 (ETH_AVDD3V3)
/SoC/ETH_EXTR: R31.1, U6.72 (ETH_EXTR)
/SoC/FRONT_KEY: C37.1, R19.2, R20.1, U6.65 (GPIO1_C0_d)
/SoC/HW_REV: C42.1, R22.2, R23.1, U6.15 (SARADC_IN1)
/SoC/KEY_IN: D6.1 (K), J4.1, R20.2
/SoC/LED_K: D7.1 (K), J5.2, R24.1
/SoC/LED_SYS: R25.1, U6.64 (GPIO1_C1_d)
/SoC/OSC_XIN: C57.1, R27.1, U6.45 (OSC_XIN), Y1.1
/SoC/OSC_XOUT: R27.2, R28.2, U6.46 (OSC_XOUT)
/SoC/RECOVERY: C43.1, R21.2, SW1.1, U6.16 (SARADC_IN0)
/SoC/XTAL_OUT: C58.1, R28.1, Y1.3
/USB_DN: U6.18 (USB_DM); also elsewhere on the board
/USB_DP: U6.19 (USB_DP); also elsewhere on the board
GND: C24.2, C25.2, C26.2, C27.2, C28.2, C29.2, C30.2, C31.2, C32.2, C33.2, C34.2, C35.2, C36.2, C37.2, C38.2, C39.2, C40.2, C41.2, C42.2, C43.2, C44.2, C45.2, C46.2, C47.2, C48.2, C49.2, C50.2, C51.2, C52.2, C53.2, C54.2, C55.2, C56.2, C57.2, C58.2, C59.2, C60.2, C61.2, C62.2, C63.2, D6.2 (A), D7.2 (A), J3.3, J4.2, Q2.2 (S), R23.2, R26.2, R30.2, R31.2, SW1.2, U6.41 (TVSS), U6.89 (VSS(EP)), Y1.2 (G), Y1.4 (G); also elsewhere on the board
unnamed: Q2.3 (D), R24.2
unnamed: Q2.1 (G), R25.2, R26.1
VCC_1V8: C24.1, C25.1, C26.1, C27.1, C28.1, C29.1, FB1.1, FB3.1, R21.1, R22.1, R29.1, U6.23 (CODEC_AVDD1V8), U6.38 (DDR_PLL_AVDD1V8), U6.47 (OSC_AVDD1V8/PLL_AVDD1V8), U6.88 (MIPI_AVDD1V8/GPIO7_VCC1V8); also elsewhere on the board
VCC_3V3: C44.1, C45.1, C46.1, C47.1, C48.1, C49.1, C50.1, C51.1, FB2.1, J5.1, R19.1, U6.7 (GPIO4_VCC3V3), U6.20 (USB_AVDD3V3), U6.27 (GPIO3_VCC), U6.43 (PMU_VCC3V3), U6.51 (GPIO1_VCC3V3), U6.59 (GPIO6_VCC); also elsewhere on the board
VCC_DDR: C52.1, C53.1, C54.1, C55.1, C56.1, FB1.2, U6.34 (DDR_VDDQ_1), U6.35 (DDR_VDDQ_2), U6.40 (DDR_VDDQ_3)
VDD_0V9: C30.1, C31.1, C32.1, C33.1, C34.1, C35.1, C36.1, C38.1, C39.1, C40.1, C41.1, U6.6 (DVDD_1), U6.36 (DVDD_2), U6.39 (DVDD_3), U6.44 (OSC_PLL_PMU_DVDD), U6.58 (DVDD_4), U6.73 (DVDD_5), U6.74 (CPU_DVDD), U6.75 (DVDD_6); also elsewhere on the board

Notes on the sheet:
ETH PHY supply filter: FB2/FB3 120R + 100nF (U6 pin 71/66, as Luckfox)
VDD_0V9 decoupling (U6 6/36/39/44/58/73/74/75)
Recovery key = SW1
VCC_3V3 decoupling (U6 7/20/27/43/51/59)
LED_SYS High = LED on
HW_REV (SARADC_IN1): rev A = 100k/100k = 0.9 V, keep >= 0.3 V between revisions
VCC_1V8 decoupling (U6 23/38/47/88)
FRONT_KEY = GPIO1_C0 (pin 65, 3.3 V), pressed = Low. LED_SYS = GPIO1_C1 (pin 64). Pins 1-5 (GPIO3_C4..D0) are 1.8 V only (GPIO7 domain): ETH LEDs on pins 1/3 run at 1.8 V (dim/off, accepted).
USB PHY supply / codec VCM / DRAM ZQ / ETH REXT
VCC_DDR decoupling (U6 34/35/40), FB1 from VCC_1V8, as Luckfox
24 MHz crystal
