ALT2-ASH/HW_RV1103_ESP32_Controller_Gateway/rv1103_esp32.kicad_pcb

## KiCad design rv1103_esp32.kicad_pcb (continued)

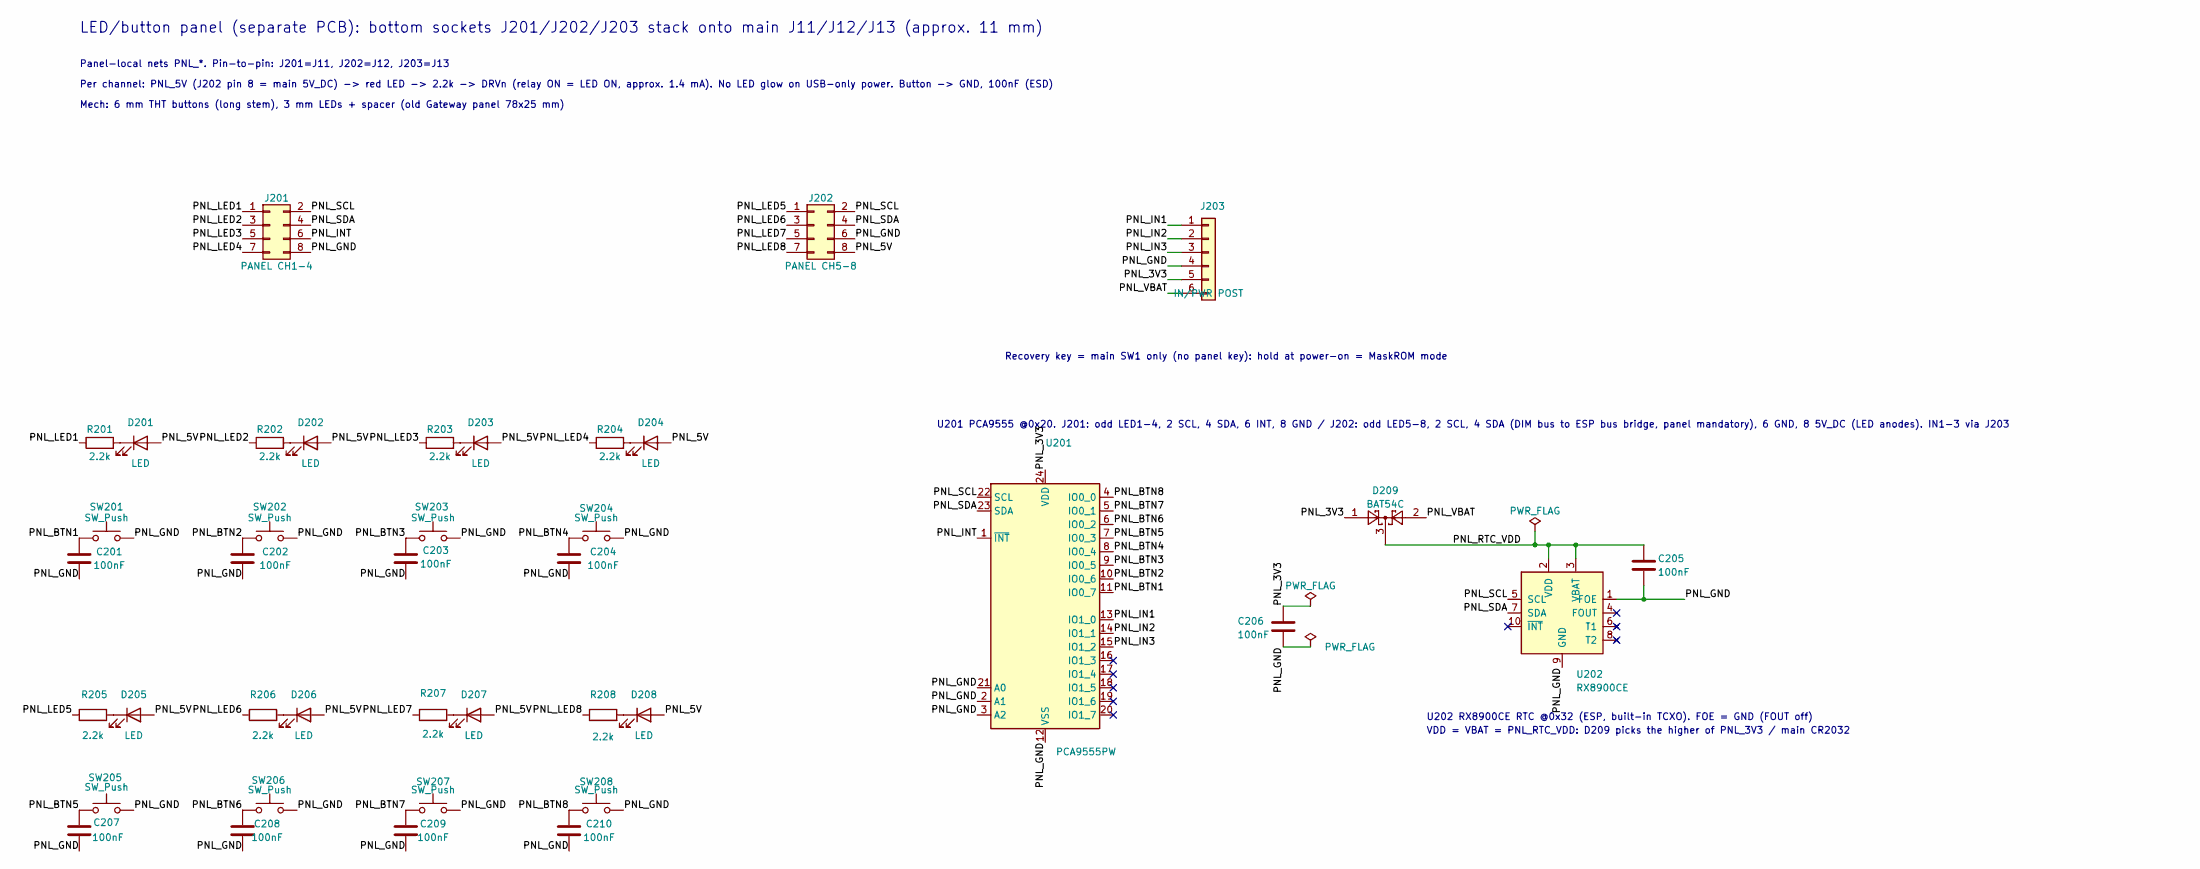
[picture p6: schematic panel.kicad_sch]

Parts:
C201, C202, C203, C204, C205, C206, C207, C208, C209, C210: 100nF; C_0603_1608Metric; LCSC C14663
D201, D202, D203, D204, D205, D206, D207, D208: LED; LED_D3.0mm; MPN 204-10SURD/S530-A3-L; LCSC C99771
D209: BAT54C; SOT-23; MPN BAT54C,215; LCSC C37704
J201: PANEL CH1-4; PinSocket_2x04_P2.54mm_Vertical; MPN PM254V-12-08-H85; LCSC C55223345
J202: PANEL CH5-8; PinSocket_2x04_P2.54mm_Vertical; MPN PM254V-12-08-H85; LCSC C55223345
J203: IN/PWR POST; PinSocket_1x06_P2.54mm_Vertical; MPN PM254V-11-06-H85; LCSC C2832269
R201, R202, R203, R204, R205, R206, R207, R208: 2.2k; R_0603_1608Metric; LCSC C4190
SW201, SW202, SW203, SW204, SW205, SW206, SW207, SW208: SW_Push; SW_PUSH_6mm_H8mm; MPN TC-6610-17-260G; LCSC C2845266
U201: PCA9555PW; TSSOP-24_4.4x7.8mm_P0.65mm; MPN PCA9555PW,118; LCSC C128392
U202: RX8900CE; EPSON_CE-USON-10_USON-10_3.2x2.5mm_P0.7mm; MPN RX8900CE-NF; LCSC C54946598

Connections:
/Panel/PNL_3V3: C206.1, D209.1, J203.5, U201.24 (VDD)
/Panel/PNL_5V: D201.2 (A), D202.2 (A), D203.2 (A), D204.2 (A), D205.2 (A), D206.2 (A), D207.2 (A), D208.2 (A), J202.8
/Panel/PNL_BTN1: C201.1, SW201.1, U201.11 (IO0_7)
/Panel/PNL_BTN2: C202.1, SW202.1, U201.10 (IO0_6)
/Panel/PNL_BTN3: C203.1, SW203.1, U201.9 (IO0_5)
/Panel/PNL_BTN4: C204.1, SW204.1, U201.8 (IO0_4)
/Panel/PNL_BTN5: C207.1, SW205.1, U201.7 (IO0_3)
/Panel/PNL_BTN6: C208.1, SW206.1, U201.6 (IO0_2)
/Panel/PNL_BTN7: C209.1, SW207.1, U201.5 (IO0_1)
/Panel/PNL_BTN8: C210.1, SW208.1, U201.4 (IO0_0)
/Panel/PNL_GND: C201.2, C202.2, C203.2, C204.2, C205.2, C206.2, C207.2, C208.2, C209.2, C210.2, J201.8, J202.6, J203.4, SW201.2, SW202.2, SW203.2, SW204.2, SW205.2, SW206.2, SW207.2, SW208.2, U201.2 (A1), U201.3 (A2), U201.12 (VSS), U201.21 (A0), U202.1 (FOE), U202.9 (GND)
/Panel/PNL_IN1: J203.1, U201.13 (IO1_0)
/Panel/PNL_IN2: J203.2, U201.14 (IO1_1)
/Panel/PNL_IN3: J203.3, U201.15 (IO1_2)
/Panel/PNL_INT: J201.6, U201.1 (~INT)
/Panel/PNL_LED1: J201.1, R201.1
/Panel/PNL_LED2: J201.3, R202.1
/Panel/PNL_LED3: J201.5, R203.1
/Panel/PNL_LED4: J201.7, R204.1
/Panel/PNL_LED5: J202.1, R205.1
/Panel/PNL_LED6: J202.3, R206.1
/Panel/PNL_LED7: J202.5, R207.1
/Panel/PNL_LED8: J202.7, R208.1
/Panel/PNL_RTC_VDD: C205.1, D209.3, U202.2 (VDD), U202.3 (VBAT)
/Panel/PNL_SCL: J201.2, J202.2, U201.22 (SCL), U202.5 (SCL)
/Panel/PNL_SDA: J201.4, J202.4, U201.23 (SDA), U202.7 (SDA)
/Panel/PNL_VBAT: D209.2, J203.6
unnamed: D201.1 (K), R201.2
unnamed: D202.1 (K), R202.2
unnamed: D203.1 (K), R203.2
unnamed: D204.1 (K), R204.2
unnamed: D205.1 (K), R205.2
unnamed: D206.1 (K), R206.2
unnamed: D207.1 (K), R207.2
unnamed: D208.1 (K), R208.2

Notes on the sheet:
U202 RX8900CE RTC @0x32 (ESP, built-in TCXO). FOE = GND (FOUT off)
VDD = VBAT = PNL_RTC_VDD: D209 picks the higher of PNL_3V3 / main CR2032
U201 PCA9555 @0x20. J201: odd LED1-4, 2 SCL, 4 SDA, 6 INT, 8 GND / J202: odd LED5-8, 2 SCL, 4 SDA (DIM bus to ESP bus bridge, panel mandatory), 6 GND, 8 5V_DC (LED anodes). IN1-3 via J203
Mech: 6 mm THT buttons (long stem), 3 mm LEDs + spacer (old Gateway panel 78x25 mm)
LED/button panel (separate PCB): bottom sockets J201/J202/J203 stack onto main J11/J12/J13 (approx. 11 mm)
Recovery key = main SW1 only (no panel key): hold at power-on = MaskROM mode
Panel-local nets PNL_*. Pin-to-pin: J201=J11, J202=J12, J203=J13
Per channel: PNL_5V (J202 pin 8 = main 5V_DC) -> red LED -> 2.2k -> DRVn (relay ON = LED ON, approx. 1.4 mA). No LED glow on USB-only power. Button -> GND, 100nF (ESD)

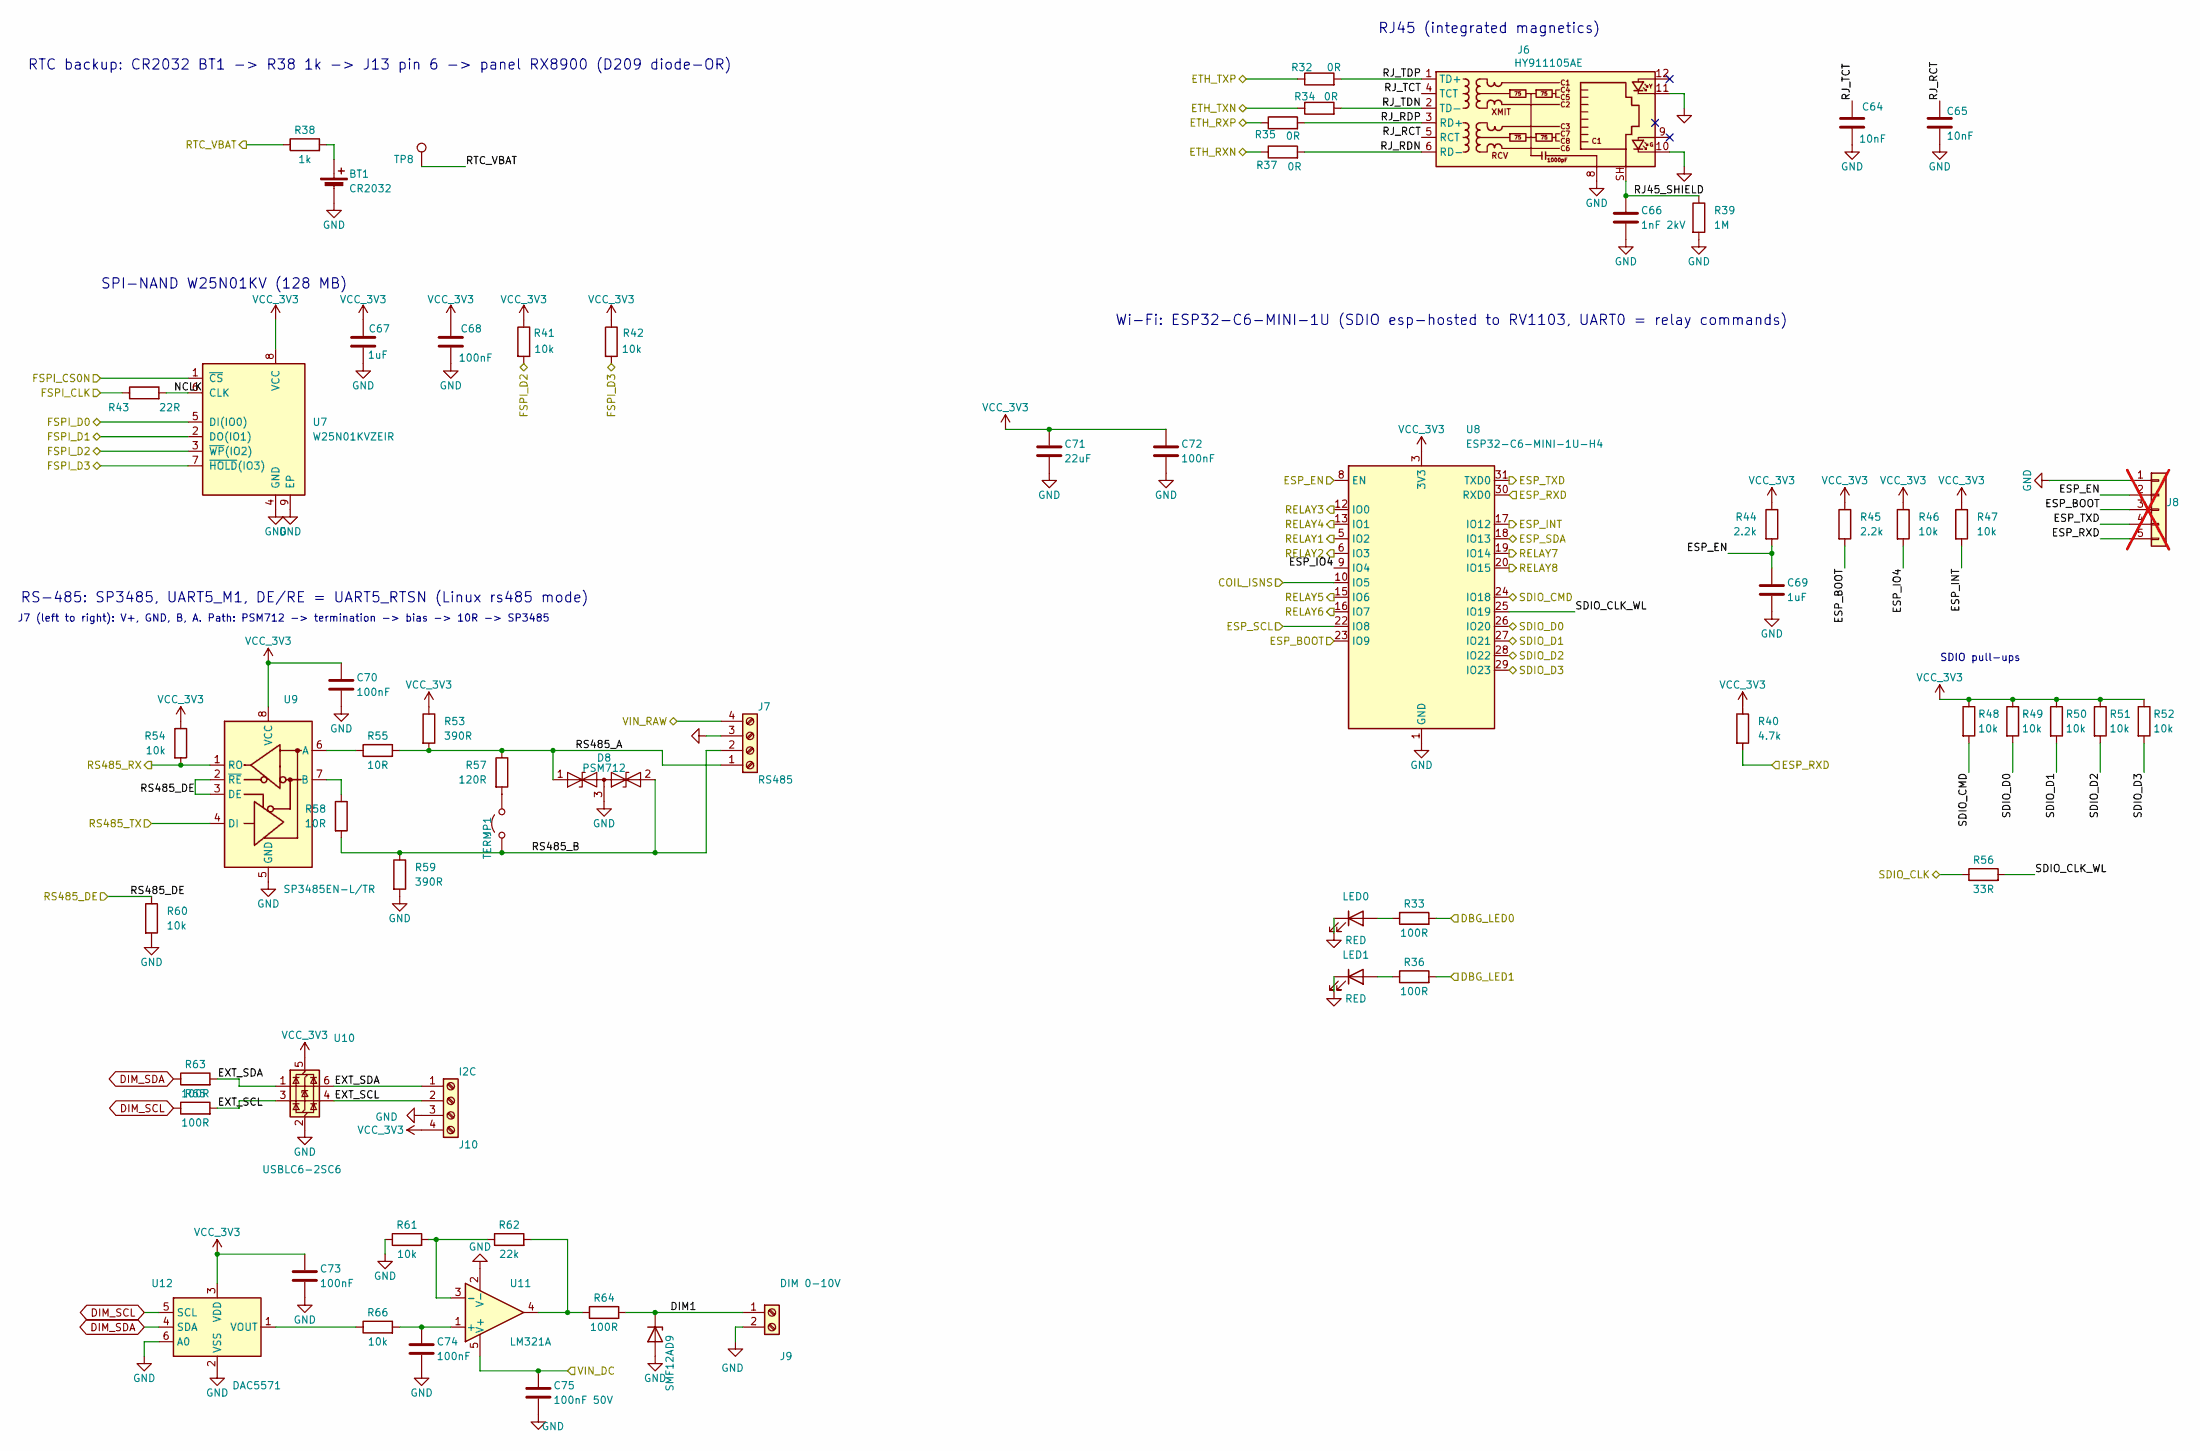
[picture p7: schematic peripheral.kicad_sch]

Parts:
BT1: CR2032; BatteryHolder_MYOUNG_BS-05_CR2032_Vertical_Overhang; MPN BS-05-A1BK017; LCSC C2902326
C64, C65: 10nF; C_0402_1005Metric; LCSC C15195
C66: 1nF 2kV; C_1206_3216Metric; Voltage 2kV; LCSC C9196
C67, C69: 1uF; C_0402_1005Metric; LCSC C52923
C68, C70, C72, C73, C74: 100nF; C_0402_1005Metric; LCSC C1525
C71: 22uF; C_0603_1608Metric; LCSC C59461
C75: 100nF 50V; C_0603_1608Metric; LCSC C14663
D8: PSM712; SOT-23; MPN PSM712-LF-T7; LCSC C32677
D9: SMF12A; D_SOD-123F; LCSC C19077506
J6: HY911105AE; RJ45_Hanrun_HY911105AE_Horizontal; LCSC C69427
J7: RS485; TerminalBlock_DB127V-5.0_1x04_P5.00mm; MPN DB127V-5.0-4P-GN-S; LCSC C430624
J8: ESP32 DEBUG; PinHeader_1x05_P2.54mm_Vertical; not fitted
J9: DIM 0-10V; TerminalBlock_DB127V-5.0_1x02_P5.00mm; MPN DB127V-5.0-2P-GN-S; LCSC C395885
J10: I2C; TerminalBlock_DB127V-5.0_1x04_P5.00mm; MPN DB127V-5.0-4P-GN-S; LCSC C430624
JP1: TERM; SolderJumper-2_P1.3mm_Open_RoundedPad1.0x1.5mm
LED0, LED1: RED; LED_0603_1608Metric; MPN KT-0603R; LCSC C2286
R32, R34, R35, R37: 0R; R_0402_1005Metric; LCSC C17168
R33, R36, R63, R64, R65: 100R; R_0402_1005Metric; LCSC C25076
R38: 1k; R_0402_1005Metric; LCSC C11702
R39: 1M; R_0402_1005Metric; LCSC C26083
R40: 4.7k; R_0402_1005Metric; LCSC C25900
R41, R42, R46, R47, R48, R49, R50, R51, R52, R54, R60, R61, R66: 10k; R_0402_1005Metric; LCSC C25744
R43: 22R; R_0402_1005Metric; LCSC C25092
R44, R45: 2.2k; R_0402_1005Metric; LCSC C25879
R53, R59: 390R; R_0603_1608Metric; MPN 0603WAF3900T5E; LCSC C23151
R55, R58: 10R; R_0805_2012Metric; LCSC C17415
R56: 33R; R_0402_1005Metric; LCSC C25105
R57: 120R; R_0603_1608Metric; LCSC C22787
R62: 22k; R_0402_1005Metric; LCSC C25768
TP8: RTC_VDD; TestPoint_Pad_D1.5mm
U7: W25N01KVZEIR; WSON-8-1EP_8x6mm_P1.27mm_EP3.4x4.3mm_HandSolder; MPN W25N01KVZEIR; LCSC C22472329
U8: ESP32-C6-MINI-1U-H4; ESP32-C6-MINI-1U; MPN ESP32-C6-MINI-1U-H4; LCSC C20627095
U9: SP3485EN-L/TR; SOIC-8_3.9x4.9mm_P1.27mm; MPN SP3485EN-L/TR; LCSC C8963
U10: USBLC6-2SC6; SOT-23-6; LCSC C7519
U11: LM321A; SOT-23-5; MPN LM321A-TR; LCSC C2842352
U12: DAC5571; SOT-23-6; MPN DAC5571IDBVR; LCSC C24061

Connections:
/COIL_ISNS: U8.10 (IO5); also elsewhere on the board
/DBG_LED0: R33.2; also elsewhere on the board
/DBG_LED1: R36.2; also elsewhere on the board
/ESP_BOOT: J8.3, R45.2, U8.23 (IO9); also elsewhere on the board
/ESP_EN: C69.1, J8.2, R44.2, U8.8 (EN); also elsewhere on the board
/ESP_INT: R47.2, U8.17 (IO12); also elsewhere on the board
/ESP_RXD: J8.5, R40.2, U8.30 (RXD0); also elsewhere on the board
/ESP_SCL: U8.22 (IO8); also elsewhere on the board
/ESP_SDA: U8.18 (IO13); also elsewhere on the board
/ESP_TXD: J8.4, U8.31 (TXD0); also elsewhere on the board
/ETH_RXN: R37.1; also elsewhere on the board
/ETH_RXP: R35.1; also elsewhere on the board
/ETH_TXN: R34.1; also elsewhere on the board
/ETH_TXP: R32.1; also elsewhere on the board
/FSPI_CLK: R43.1; also elsewhere on the board
/FSPI_CS0N: U7.1 (~CS); also elsewhere on the board
/FSPI_D0: U7.5 (DI(IO0)); also elsewhere on the board
/FSPI_D1: U7.2 (DO(IO1)); also elsewhere on the board
/FSPI_D2: R41.2, U7.3 (~WP(IO2)); also elsewhere on the board
/FSPI_D3: R42.2, U7.7 (~HOLD(IO3)); also elsewhere on the board
/Peripheral/DIM1: D9.1 (K), J9.1, R64.2
/Peripheral/ESP_IO4: R46.2, U8.9 (IO4)
/Peripheral/EXT_SCL: J10.2, R65.2, U10.3 (I/O2), U10.4 (I/O2)
/Peripheral/EXT_SDA: J10.1, R63.2, U10.1 (I/O1), U10.6 (I/O1)
/Peripheral/NCLK: R43.2, U7.6 (CLK)
/Peripheral/RJ45_SHIELD: C66.1, J6.SH, R39.1
/Peripheral/RJ_RCT: C65.1, J6.5 (RCT)
/Peripheral/RJ_RDN: J6.6 (RD-), R37.2
/Peripheral/RJ_RDP: J6.3 (RD+), R35.2
/Peripheral/RJ_TCT: C64.1, J6.4 (TCT)
/Peripheral/RJ_TDN: J6.2 (TD-), R34.2
/Peripheral/RJ_TDP: J6.1 (TD+), R32.2
/Peripheral/RS485_A: D8.1 (A1), J7.1, R53.2, R55.2, R57.1
/Peripheral/RS485_B: D8.2 (A2), J7.2, JP1.1 (A), R58.2, R59.1
/Peripheral/SDIO_CLK_WL: R56.2, U8.25 (IO19)
/RELAY1: U8.5 (IO2); also elsewhere on the board
/RELAY2: U8.6 (IO3); also elsewhere on the board
/RELAY3: U8.12 (IO0); also elsewhere on the board
/RELAY4: U8.13 (IO1); also elsewhere on the board
/RELAY5: U8.15 (IO6); also elsewhere on the board
/RELAY6: U8.16 (IO7); also elsewhere on the board
/RELAY7: U8.19 (IO14); also elsewhere on the board
/RELAY8: U8.20 (IO15); also elsewhere on the board
/RS485_DE: R60.1, U9.2 (~RE), U9.3 (DE); also elsewhere on the board
/RS485_RX: R54.2, U9.1 (RO); also elsewhere on the board
/RS485_TX: U9.4 (DI); also elsewhere on the board
/RTC_VBAT: R38.1, TP8.1 (1_1); also elsewhere on the board
/SDIO_CLK: R56.1; also elsewhere on the board
/SDIO_CMD: R48.2, U8.24 (IO18); also elsewhere on the board
/SDIO_D0: R49.2, U8.26 (IO20); also elsewhere on the board
/SDIO_D1: R50.2, U8.27 (IO21); also elsewhere on the board
/SDIO_D2: R51.2, U8.28 (IO22); also elsewhere on the board
/SDIO_D3: R52.2, U8.29 (IO23); also elsewhere on the board
/VIN_DC: C75.1, U11.5 (V+); also elsewhere on the board
/VIN_RAW: J7.4; also elsewhere on the board
DIM_SCL: R65.1, U12.5 (SCL); also elsewhere on the board
DIM_SDA: R63.1, U12.4 (SDA); also elsewhere on the board
GND: BT1.2 (-), C64.2, C65.2, C66.2, C67.2, C68.2, C69.2, C70.2, C71.2, C72.2, C73.2, C74.2, C75.2, D8.3 (common), D9.2 (A), J6.8, J6.10, J6.11, J7.3, J8.1, J9.2, J10.3, LED0.1 (K), LED1.1 (K), R39.2, R59.2, R60.2, R61.1, U7.4 (GND), U7.9 (EP), U8.1 (GND), U8.2 (GND), U8.11 (GND), U8.14 (GND), U8.36 (GND), U8.37 (GND), U8.38 (GND), U8.39 (GND), U8.40 (GND), U8.41 (GND), U8.42 (GND), U8.43 (GND), U8.44 (GND), U8.45 (GND), U8.46 (GND), U8.47 (GND), U8.48 (GND), U8.49 (GND), U8.50 (GND), U8.51 (GND), U8.52 (GND), U8.53 (GND), U9.5 (GND), U10.2 (GND), U11.2 (V-), U12.2 (VSS), U12.6 (A0); also elsewhere on the board
unnamed: BT1.1 (+), R38.2
unnamed: JP1.2 (B), R57.2
unnamed: LED0.2 (A), R33.1
unnamed: LED1.2 (A), R36.1
unnamed: R62.2, R64.1, U11.4
unnamed: R55.1, U9.6 (A)
unnamed: R58.1, U9.7 (B)
unnamed: C74.1, R66.2, U11.1 (+)
unnamed: R61.2, R62.1, U11.3 (-)
unnamed: R66.1, U12.1 (VOUT)
VCC_3V3: C67.1, C68.1, C70.1, C71.1, C72.1, C73.1, J10.4, R40.1, R41.1, R42.1, R44.1, R45.1, R46.1, R47.1, R48.1, R49.1, R50.1, R51.1, R52.1, R53.1, R54.1, U7.8 (VCC), U8.3 (3V3), U9.8 (VCC), U10.5 (VBUS), U12.3 (VDD); also elsewhere on the board

Notes on the sheet:
RTC backup: CR2032 BT1 -> R38 1k -> J13 pin 6 -> panel RX8900 (D209 diode-OR)
Wi-Fi: ESP32-C6-MINI-1U (SDIO esp-hosted to RV1103, UART0 = relay commands)
J7 (left to right): V+, GND, B, A. Path: PSM712 -> termination -> bias -> 10R -> SP3485
SDIO pull-ups
RJ45 (integrated magnetics)
RS-485: SP3485, UART5_M1, DE/RE = UART5_RTSN (Linux rs485 mode)
SPI-NAND W25N01KV (128 MB)

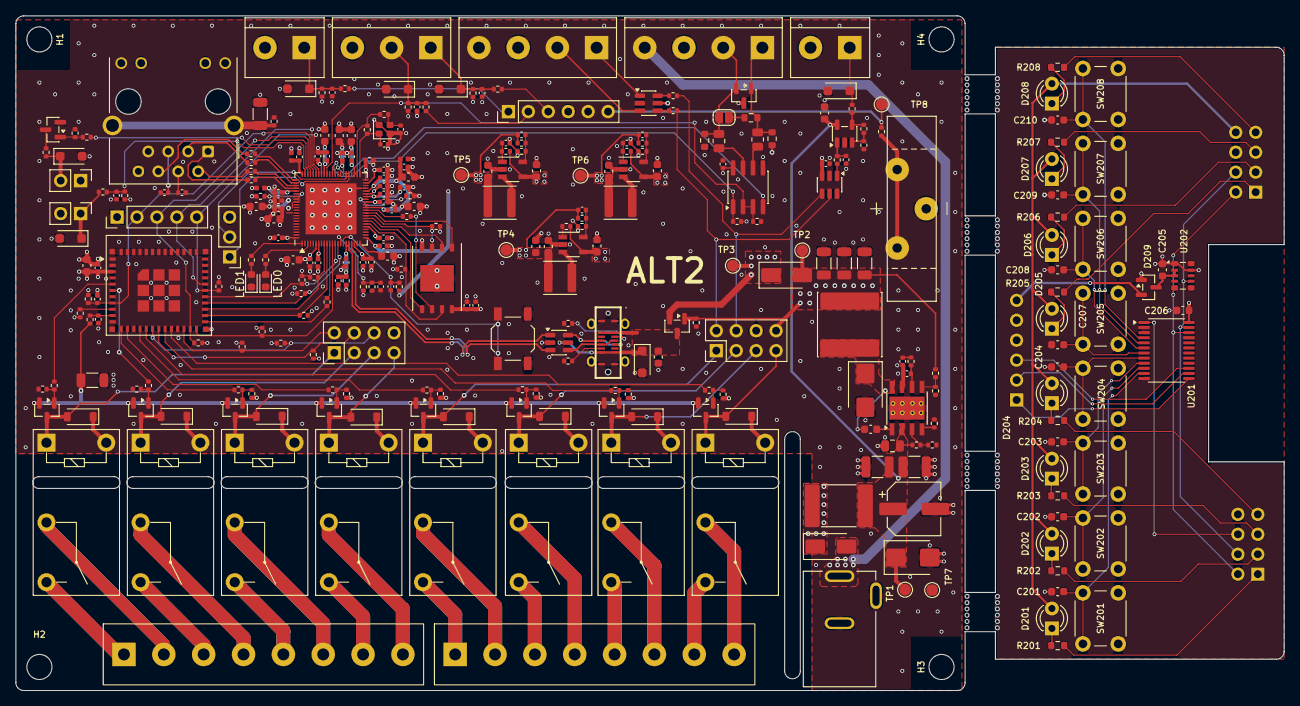
[picture p8: board rv1103_esp32.kicad_pcb from above]

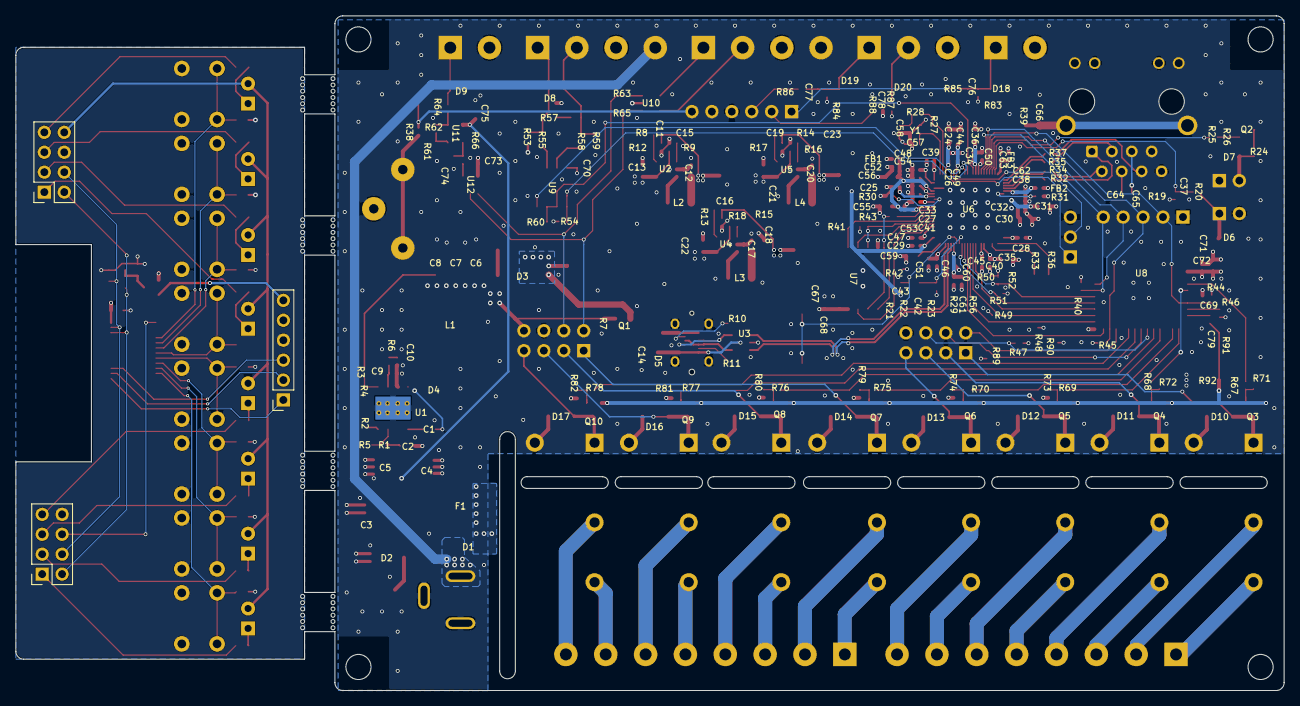
[picture p9: board rv1103_esp32.kicad_pcb from below]

Board: 4 copper layers, 161.7 x 86.0 mm, 308 parts (3 on the bottom side), 189 nets.

Other parts of the board:
MB1, MB2, MB3, MB4: MouseBite; MouseBite_5mm_Gap3.873mm
