ALT2-ASH/HW_RV1103_ESP32_Controller_Gateway/(commit log)

2026-11-04 Initial commit: RV1103G1 + ESP32-C6 controller gateway board
    KiCad project (schematic, 4-layer PCB, DRC rules, project libraries
    and 3D models). State: full DRC with refill has 0 schematic-parity
    issues; remaining items are USB diff-pair 0.1493 mm clearance and
    USBLC6 flow-through pads (U6/U15) reported as unconnected.
    [io.kicad_sch, panel.kicad_sch, peripheral.kicad_sch, power.kicad_sch, rv1103_esp32.kicad_pcb, rv1103_esp32.kicad_sch, soc.kicad_sch]
2026-11-04 Panel to right side, silk/3D models, GND via rework, BOM updates
    - Schematic: LCSC/MPN for every fitted part (basic substitutes C24/C25,
    J201/J202, D8 PSM712, J7, J203, SW1); J10 split into 3P J10 + 2P J17;
    J2 changed to DC-005-A200 (C720557)
    - New footprints: DC-005-A200_XUNPU_Horizontal, DB127V-5.0 1x03
    - New 3D models (EasyEDA): DB127V-5.0-3P, DC-005-A200, G5Q-1A4 relay,
    RX8900CE; L4 uses SWPA8040S scaled to 6.5 mm; J7/J9 model paths moved
    into lib/3dmodels
    - Top row terminals and RJ45 evenly spaced (1.116 mm gaps)
    - Panel board rotated 90 deg and moved to the right side, 4 mouse-bite tabs
    - All reference designators visible on silk
    - GND vias: island/stitch vias, cap/TVS pad vias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
    [io.kicad_sch, panel.kicad_sch, peripheral.kicad_sch, power.kicad_sch, rv1103_esp32.kicad_pcb, soc.kicad_sch]
2026-11-04 Fix RS485_TX to GND via clearance near C44
    [rv1103_esp32.kicad_pcb]
2026-11-04 Panel: 17mm tact switches (C2845266), red DIP LEDs on 10mm spacers (C94096) with 3D models
    [panel.kicad_sch, rv1103_esp32.kicad_pcb]
2026-11-04 JLC cost: basic/preferred swaps, third 5V_DC 47uF, C11 0805 100V, production files
    - SW1 RECOVERY -> TS-1187A (C318884, basic)
    - U6/U15 USBLC6-2SC6 -> SRV05-4 (C7420376, preferred)
    - C24/C25 47uF 1210 -> 1206 C96123 (basic), add C90 (third 47uF), evenly spaced
    - C11 100nF 100V 0603 C113803 -> 0805 C28233 (basic), C14/C15 shifted 0.3 mm
    - production/: JLC BOM (one row per LCSC, LED spacers C94096), CPL, gerber zip
    [BOM_JLCPCB.csv, peripheral.kicad_sch, power.kicad_sch, rv1103_esp32.kicad_pcb, soc.kicad_sch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]
2026-11-04 Impedance netclasses, Ethernet jack-side reroute, J1/U12 part swaps
    - ETH_100R 0.203/0.197, USB_90R 0.238/0.162 from the JLC calculator
    (JLC04161H-7628, L1 ref L2, coated, 0.2 to copper); pitch 0.40 kept
    - DRU: diff-pair gap ranges updated; USB U7 fan-out neck kept at 0.20/0.15
    - USB re-routed (user); RJ45 J5 to 0R column rerouted with 45-degree runs
    - J1 TYPE-C-31-D-06 -> TYPE-C-31-D-06A (C22464422, same land pattern)
    - U12 MAX3485EESA+T -> SP3485EN-L/TR (C8963, basic, same pinout)
    - C11 PCB fields synced with schematic; production files regenerated
    [BOM_JLCPCB.csv, peripheral.kicad_sch, power.kicad_sch, rv1103_esp32.kicad_pcb]
2026-11-04 GND via touch-ups (user), regenerate JLC production files
    [rv1103_esp32.kicad_pcb]
2026-11-05 VDD_0V9 to 0.906 V (R6 51k), place origin at board lower-left, centred CPL for THT parts
    - R6 47k -> 51k (C25794, 0402WGF5102TCE): 0.6*(1+51k/100k) = 0.906 V
    - aux (drill/place) origin set to board lower-left so gerber/drill/CPL coords are positive and aligned
    - CPL: THT parts with pin-1 anchors use courtyard centre; regenerated BOM/CPL/gerber zip
    [BOM_JLCPCB.csv, power.kicad_sch, rv1103_esp32.kicad_pcb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]
2026-11-05 JLC CPL fitted to JLC footprints; D3/D4/L4 part swaps; bottom parts left to hand solder
    - CPL: each part placed at its EasyEDA footprint origin/rotation, fitted to the board pads
    (fixes DC jack, RJ45, 2.54 headers, SOT-23/SOIC rotations)
    - D3 SS56B -> preferred C18199180; D4 SS510 -> SS38 C18199196 (80V 3A, preferred)
    - L4 SWPA8065S8R2 (no JLC footprint) -> FNR8065S8R2MT C168161, same 8x8 land
    - J201-J203 (bottom) removed from JLC BOM/CPL for single-sided assembly
    [BOM_JLCPCB.csv, power.kicad_sch, rv1103_esp32.kicad_pcb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]
2026-11-05 Re-annotate schematic references and update PCB
    [io.kicad_sch, panel.kicad_sch, peripheral.kicad_sch, power.kicad_sch, rv1103_esp32.kicad_pcb, rv1103_esp32.kicad_sch, soc.kicad_sch]
2026-11-05 Update schematic notes to new references, panel LEDs D201-D208 + BAT54C D209, spacer by LED footprint
    - notes/descriptions rewritten against the re-annotated refs (power, SoC, IO, peripheral, panel); R85/R86 IN1/IN3 descriptions fixed
    - PCB Description/Note fields synced with the schematic
    - panel: BAT54C D205 -> D209, LEDs renumbered to D201-D208 in board order (nets renamed)
    - production files regenerated (spacers SP201-SP208 follow the LED footprints)
    [BOM_JLCPCB.csv, io.kicad_sch, panel.kicad_sch, peripheral.kicad_sch, power.kicad_sch, rv1103_esp32.kicad_pcb, soc.kicad_sch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]
2026-11-05 F1 PTC 2.5A/48V (2920L250/48GR) for 12 V hot-enclosure margin, D1 back to SS510 5A
    - F1: Ihold 2.5 A (~1.4 A at 85 C) vs 0.8 A worst input at 10.8 V; Vmax 48 V > SMBJ33A Vbr 40.6 V
    - D1: SS38 3 A -> SS510 5 A (C65010) to carry the PTC hold/trip band (up to 5 A)
    - notes updated, production files regenerated
    [BOM_JLCPCB.csv, power.kicad_sch, rv1103_esp32.kicad_pcb]
2026-11-05 PCB: silkscreen cleanup (hide/move texts), remove 8 graphics, 4 track segments, zone refill
    [rv1103_esp32.kicad_pcb]
2026-11-05 PCB: silkscreen refs 0.8 mm / 0.15 mm, auto-placed clear of pads and other texts (C38/C39 to bottom silk)
    [rv1103_esp32.kicad_pcb]
2026-11-05 PCB: silkscreen touch-ups (move texts, 12 to B.SilkS, hide 4)
    [rv1103_esp32.kicad_pcb]
2026-11-05 Fix F1-D1 zone/vias left on stale net Net-(D4-K) after re-annotation; U3/U10 back to USBLC6-2SC6 C7519; regenerate gerber/BOM/CPL
    [BOM_JLCPCB.csv, peripheral.kicad_sch, power.kicad_sch, rv1103_esp32.kicad_pcb]
2026-11-05 Final review fixes: GND pulled 0.4 mm back from panel tabs, DRC rules remapped to new refs, CPL diode/LED polarity (D3, D9, D201-D208), LED spacer C94095 4x9 mm, stale notes and C4/C5 100V; regenerat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
    [BOM_JLCPCB.csv, panel.kicad_sch, peripheral.kicad_sch, power.kicad_sch, rv1103_esp32.kicad_pcb, soc.kicad_sch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]
2026-11-05 Board setup: min text height 0.8 mm to match silkscreen refs
2026-11-06 Panel relay LEDs from 5V_DC; restore VIN_DC label for U11
    - J12 pin 8 GND -> 5V_DC, panel J202 pin 8 -> PNL_5V
    - D201-D208 anodes PNL_3V3 -> PNL_5V, R201-R208 1k -> 2.2k (C4190)
    (no false LED-on / glow on USB-only power, no LED reverse bias)
    - Notes updated for the 5V panel supply
    - Peripheral: VIN_DC hierarchical label restored (lost during note cleanup,
    U11 LM321 V+ and C75 were isolated); note cleanup by user
    - Schematic only: PCB not yet updated from schematic, production files not regenerated
    [io.kicad_sch, panel.kicad_sch, peripheral.kicad_sch]
2026-11-06 PCB: relay LEDs routed to 5V_DC after F8, zone refill; schematic label cleanup; min text height 1.0 mm
    [io.kicad_sch, panel.kicad_sch, peripheral.kicad_sch, rv1103_esp32.kicad_pcb]
2026-11-06 GPIO7 1.8 V fix, debug LEDs, GND vias, final DRC
    - RV1103 pins 1-5 are the 1.8 V-only GPIO7 domain: FRONT_KEY -> GPIO1_C0
    (pin 65), LED_SYS -> GPIO1_C1 (pin 64), both 3.3 V GPIO.
    - RJ45 LEDs dropped (J6.9/12 NC). Pins 1/3 drive two on-board red 0603
    debug LEDs instead: D21 DBG_LED0 (GPIO3_C6), D22 DBG_LED1 (GPIO3_C4),
    R33/R36 100R (Luckfox-style, red works at 1.8 V).
    - 39 GND stitching vias, zone refill, FRONT_KEY/LED_SYS routing.
    - Notes: J7 order is V+, GND, B, A; J7 V+ (VIN_RAW) is ahead of D1/F1.
    - min text height 0.8 mm.
    - Production files regenerated (BOM 92 rows / 294 parts).
    ERC 0. DRC: 0 clearance, schematic parity OK; 4 known unconnected
    (EXT_SDA/SCL, USB_DN/DP stubs) and si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
    [BOM_JLCPCB.csv, peripheral.kicad_sch, power.kicad_sch, rv1103_esp32.kicad_pcb, rv1103_esp32.kicad_sch, soc.kicad_sch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]
2026-11-06 Debug LEDs renamed LED0/LED1, GND vias, zone refill
    - D21/D22 -> LED0/LED1 (schematic refs and nets to match the PCB).
    - Two GND stitching vias added; zones refilled (In2 3V3 overlapped them).
    - Stray 0.04 mm stub on unconnected J6 pin 9 removed.
    - ALT2 logo on F.Silkscreen.
    - Production files regenerated.
    (EXT_SDA/SCL, USB_DN/DP stubs) and silk/neck warnings remain.
    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
    [BOM_JLCPCB.csv, peripheral.kicad_sch, rv1103_esp32.kicad_pcb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]
2026-11-06 LED spacers back to C94096 (4x10 mm)
    - Panel LEDs D201-208: Spacer property C94095 4x9 -> C94096 4x10 (part in stock again).
    - Production BOM/CPL regenerated (SP201-208 = C94096).
    [BOM_JLCPCB.csv, panel.kicad_sch, rv1103_esp32.kicad_pcb]
2026-11-07 RS485_RX reroute, In2 GND islands under USB crossovers
    - RS485_RX on B.Cu moved off the In2 1V8 trace (clear of GND via)
    - In2 GND islands under the USB B.Cu crossovers: J2 (centred, all 4 SH
    pads) and RV side; existing GND vias become stitching vias
    - USB_DN reroute at J2, zones refilled
    - DRC: 0 errors, parity OK; BOM 92 rows / 294 parts, gerbers regenerated
    [rv1103_esp32.kicad_pcb]
